MikeMontana1968/tide-machine/pcb/render_bottom.png

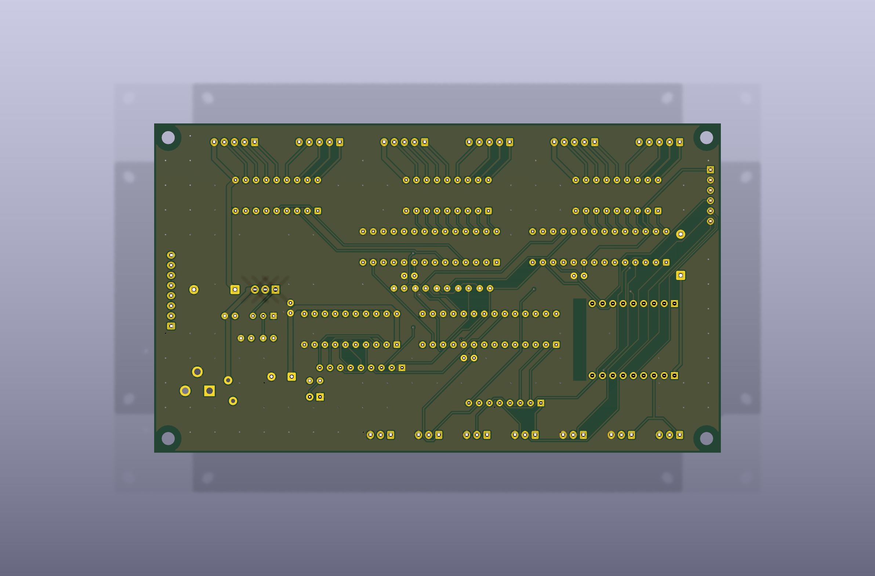
pcb/render_bottom.png
