MikeMontana1968/tide-machine/pcb/render_top.png

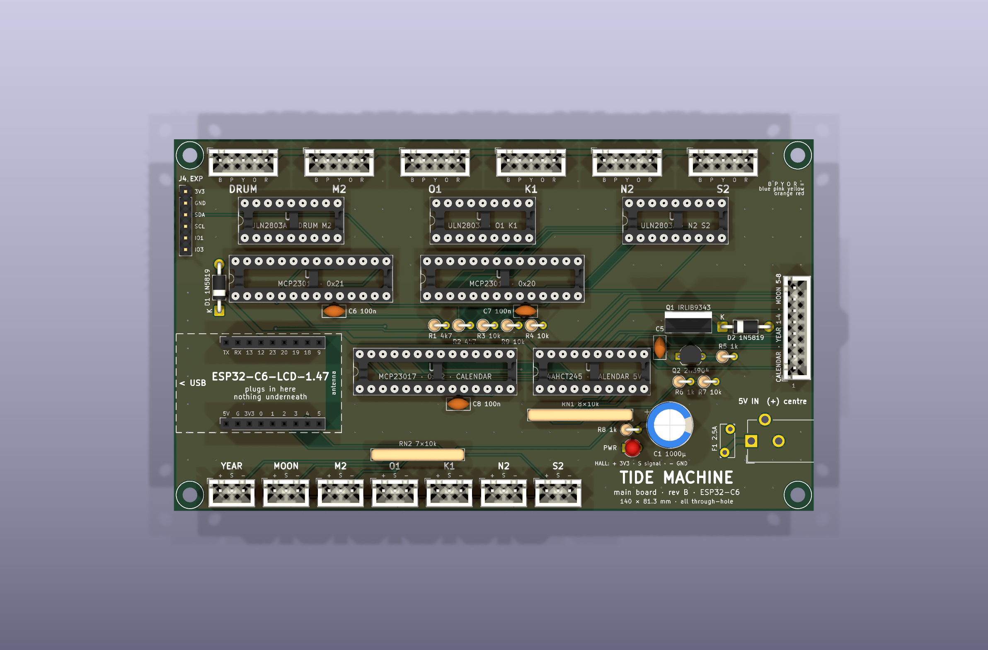
pcb/render_top.png
