MikeMontana1968/tide-machine/stl/README.txt

Tide Machine rev M: printed parts (from station_study.py --full; regenerate with export_stl.py)

PLA, 3 perimeters, no supports. Print the coupons first (RESUME.md, Printing).

hub_dial.stl               x5     52.0 x   52.0 x   5.0 mm   dial back down, boss up
arm_S2.stl                 x1     26.2 x   24.0 x   4.5 mm   back down, bearing boss up (pin radius 8.75 mm)
arm_N2.stl                 x1     24.9 x   24.0 x   4.5 mm   back down, bearing boss up (pin radius 7.35 mm)
arm_K1.stl                 x1     24.0 x   24.0 x   4.5 mm   back down, bearing boss up (pin radius 3.5 mm)
arm_O1.stl                 x1     24.0 x   24.0 x   4.5 mm   back down, bearing boss up (pin radius 2.45 mm)
arm_M2.stl                 x1     52.5 x   24.0 x   4.5 mm   back down, bearing boss up (pin radius 35 mm)
index_tab.stl              x5      6.0 x    6.0 x   4.5 mm   flat
pulley_bracket.stl         x6     30.0 x   15.7 x  15.8 mm   rail face down, as modelled
pen_carriage_rear.stl      x1     32.0 x   24.0 x   4.2 mm   front face down, pulley stub up
pen_carriage_front.stl     x1     32.0 x   24.0 x   9.0 mm   front face down, pockets open upward
year_dial.stl              x1     52.0 x   52.0 x   6.5 mm   decal face down. Hub bore is a PLACEHOLDER until the BKA30D-R5's shafts are measured
moon_disc.stl              x1     32.0 x   32.0 x   6.0 mm   decal face down. Hub bore is a PLACEHOLDER until the BKA30D-R5's shafts are measured
calendar_hand.stl          x1      6.2 x   17.0 x  12.0 mm   front face down
drum_end_cap.stl           x2     77.9 x   77.9 x   6.0 mm   flat. 7.1 mm bore added for the 7 mm shaft; how it grips the shaft is not designed yet
