MikeMontana1968/tide-machine/rails_1to1_A2.pdf

# TIDE MACHINE — RAILS AND FRAME drilling templates, 1:1

1×2 pine. Templates, not a cut file — tape a sheet to the wood, centre-punch every cross, then drill. PRINT AT 100% / ACTUAL SIZE.

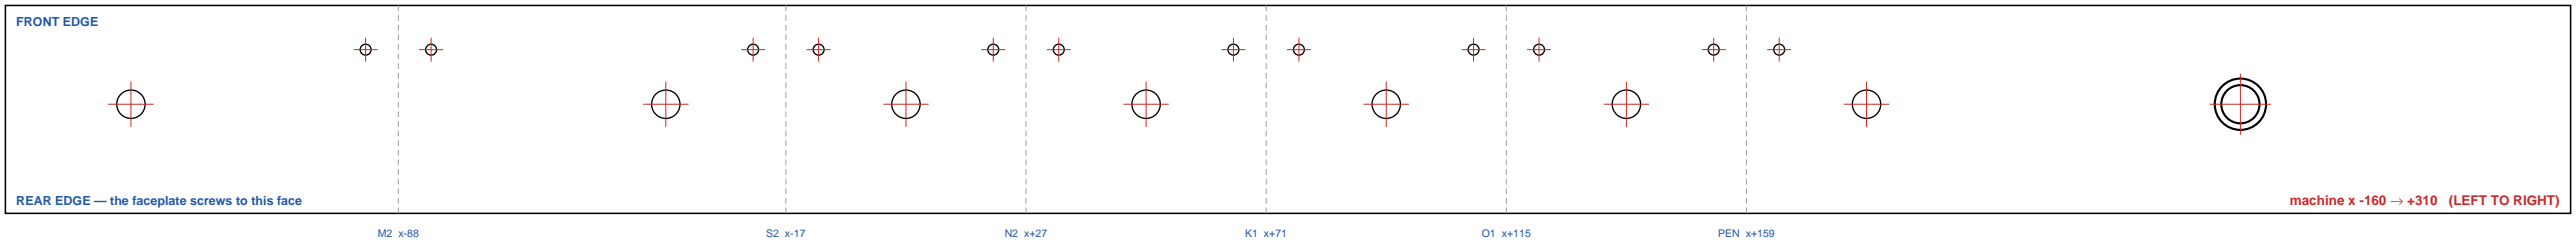
[picture p3: figure]
FRONT EDGE; machine x -160 → +310 (LEFT TO RIGHT); PEN x+159

REAR EDGE — the faceplate screws to this face

TOP RAIL — inner face (drill this face)

inner face, 470 × 38.10. 7 blind rod sockets, 12 screw-eye pilots, 1 through hole for the drum shaft.

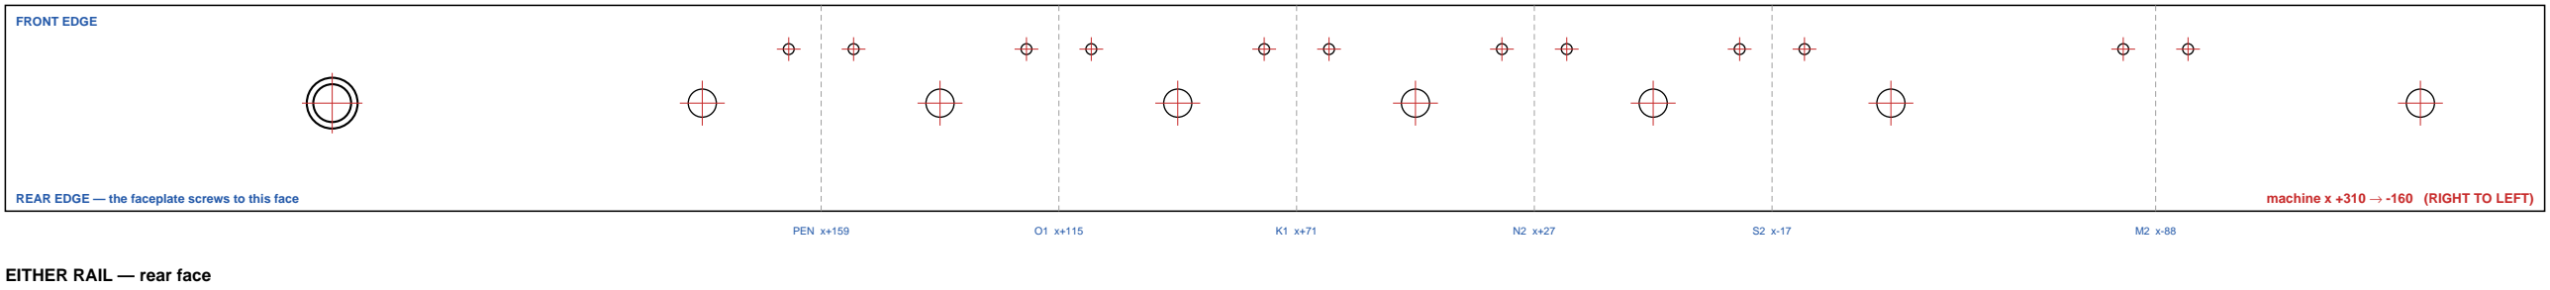
[picture p4: figure]
FRONT EDGE; machine x +310 → -160 (RIGHT TO LEFT); PEN x+159; EITHER RAIL — rear face

REAR EDGE — the faceplate screws to this face

BOTTOM RAIL — inner face (drill this face)

inner face, 470 × 38.10. 7 blind rod sockets, 12 screw-eye pilots, 1 through hole for the drum shaft.

REAR EDGE — the faceplate screws to this face

FRONT EDGE

machine x -160 → +310 (LEFT TO RIGHT) rear face, 470 × 19.05. The SAME for both rails — the pilots sit 6 mm in from the inner edge either way.

M2 x-88 | S2 x-17 | N2 x+27 | K1 x+71 | O1 x+115 | PEN x+159

END POST — 2 off, blank

140 × 38.1 from the same 1×2. Stands on end between the rails and closes the box.

No joinery drawn — that is still an open item. Fit the rails and rods dry, get it square,

then fasten the posts to whatever you have.

THE TWO RAILS ARE MIRROR IMAGES. Use the template with the matching name.
Both rails carry the same features at the same machine (x, z) — but each is drilled on its INNER face, the one that looks at the other rail. Laying the top rail inner-face-up turns it over, so with the rear edge toward you on both, machine x runs left-to-right on one rail and right-to-left on the other. Drill both from one template and the second rail is scrap.
Each template names its rail and states which way x runs. Register the REAR EDGE first, then the end.

Drill schedule
7 × Ø5.2 × 9 deep, BLIND | guide-rod sockets, 20 mm from the rear edge
12 × Ø2.0 × 9 deep | screw-eye pilots, 30 mm from the rear edge
1 × Ø7.0 THROUGH (19.05) | drum shaft at x +249.5, both rails
5 × Ø2.0 × ~10 deep | faceplate pilots — REAR face, 6 mm in from the inner edge

The screw-eye pilots leave only 8.1 mm of wood to the front edge — drill them square or pine will blow out.

Cut list
2 × rail 1×2 pine, 470 mm (19.05 × 38.1 actual)
2 × post 1×2 pine, 140 mm — stands between the rails
7 × rod Ø5 mm, 158 mm — socket bottom to socket bottom One 8 ft 1×2 covers all four wood parts (1220 mm needed).

Ordinates (machine x, mm; measure rather than trust the print)

Rod sockets Ø5.2, v 20

-137
-39
+5
+49
+93
+137
+181
—
—
—
—
—

Screw eyes Ø2.0, v 30

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
+109
+121
+153
+165

Faceplate pilots Ø2.0, v 6

-144.00
-69.75
+4.50
+78.75
+153.00

Drum shaft Ø7.0, v 20

+249.5 THROUGH

THIS BAR IS 100 mm — measure it before trusting this sheet
