MikeMontana1968/tide-machine/pcb/placement.png

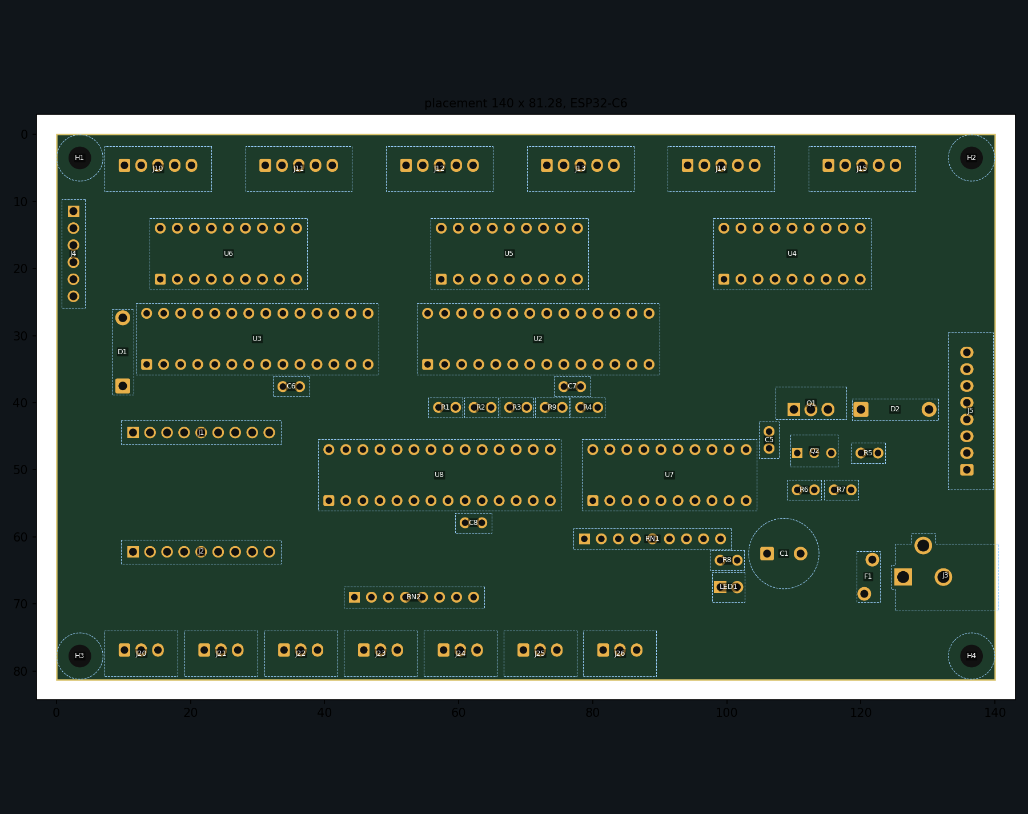
pcb/placement.png
