MikeMontana1968/tide-machine/pcb/routed_both.png

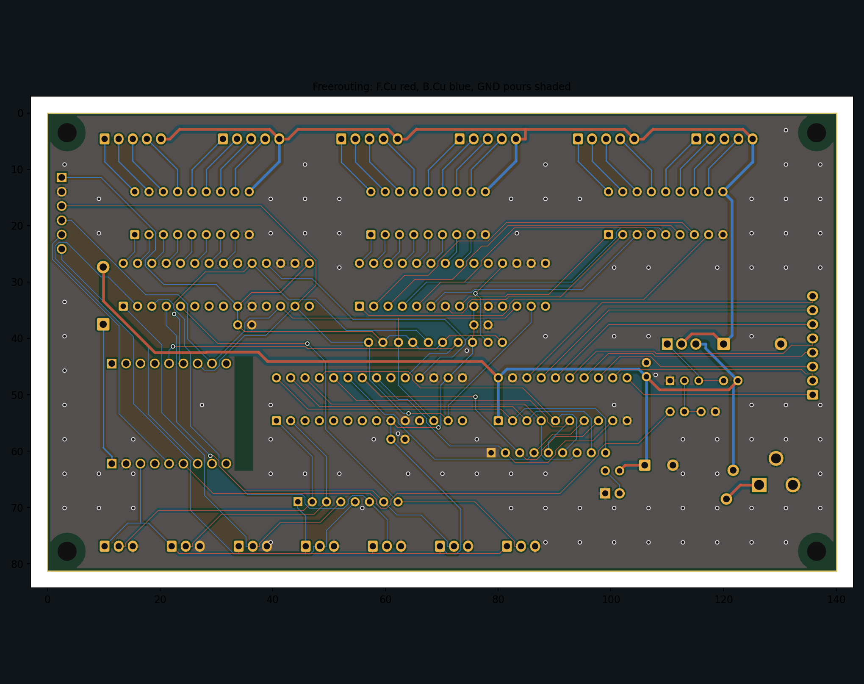
pcb/routed_both.png
