MikeMontana1968/tide-machine/pcb/routed_top.png

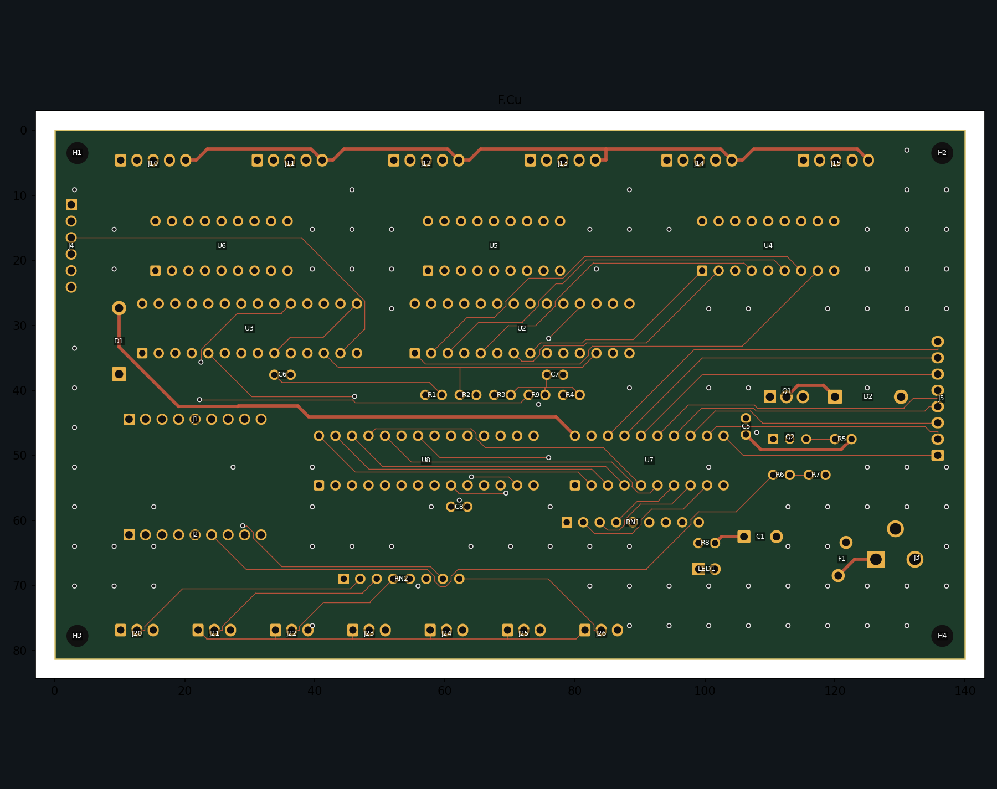
pcb/routed_top.png
