MikeMontana1968/tide-machine/pcb/silk_layout.png

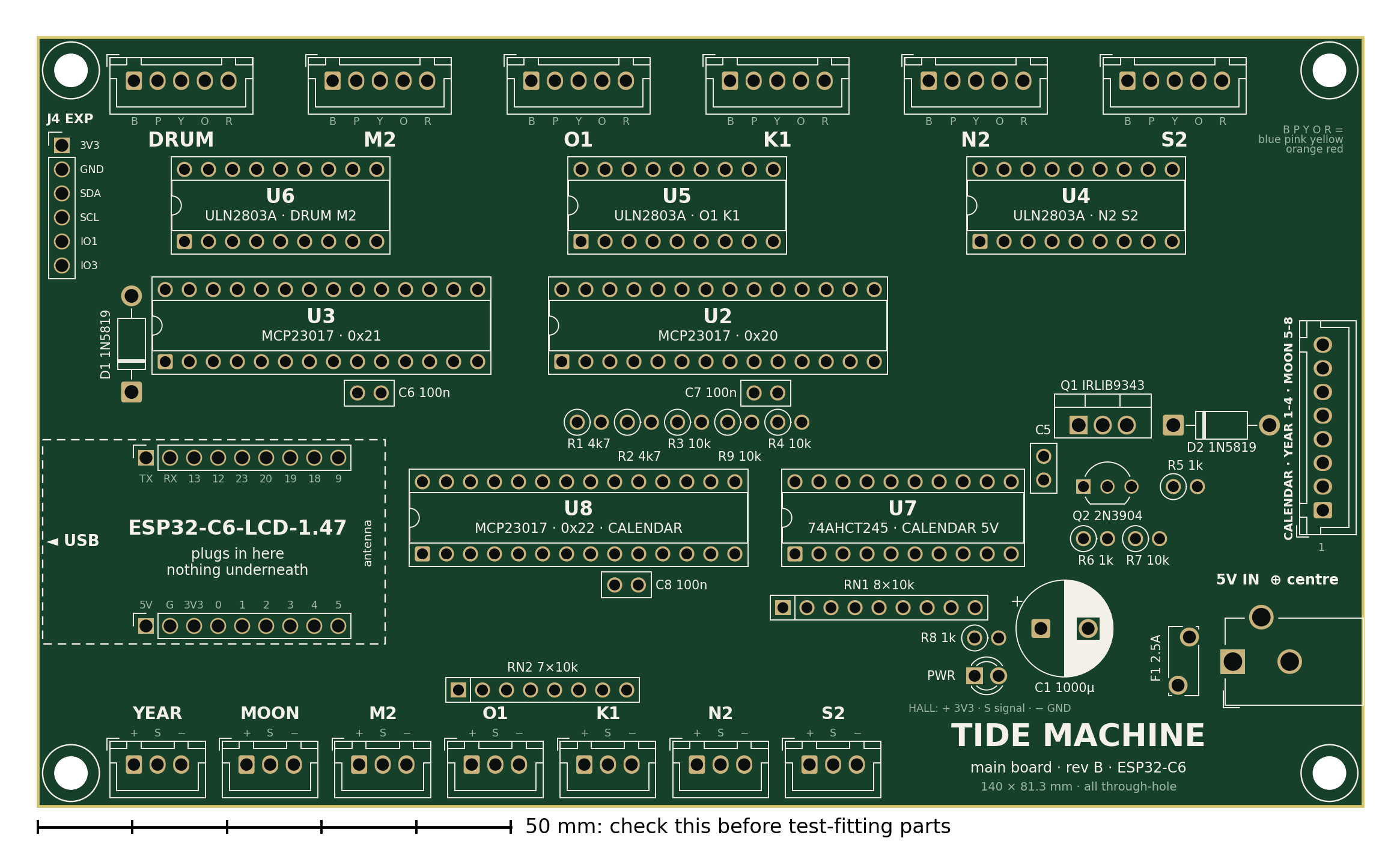
pcb/silk_layout.png
