MikeMontana1968/tide-machine/bom.csv

Section | Item | Spec / part number | Need | Order | Notes | Flag
Motion | Stepper motor | 28BYJ-48 5 V (64:1), usually sold as a kit with a ULN2003 board | 6 | 7 | Five stations + the drum. The motors plug straight into the main board; the kit's driver boards aren't needed. A 10-pack is usually cheaper per unit.
Motion | Dual-shaft gauge stepper | BKA30D-R5 (continuous 360° version) | 1 | 2 | Calendar: outer shaft = year dial, inner shaft = moon disc. Confirm both shafts spin all the way round, and measure shaft diameters and lengths, before building around it. | VERIFY BEFORE BUILDING AROUND IT
Motion | V-groove bearing | V623ZZ, 3 × 12 × 4 mm | 22 | 25 | 12 rail pulleys, 5 arms, 1 pen pulley, 4 pen carriage. Measure the groove root radius (4.8 assumed) and V angle (90° assumed) on arrival. | VERIFY BEFORE BUILDING AROUND IT
Motion | Steel rod | 3 mm ground stainless (h6), or 1/8″ (3.175 mm) O-1 drill rod | 2 × 170 mm | 2 × 300 mm | Pen guide rods, cut to 170 socket bottom to socket bottom. 4 mm and up won't seat in the V623's groove.
Motion | Shim washer | 3 × 5 × 0.5 mm (OD must be 5 mm or less) | 16 | 25 | Between the two bearings in each pulley bracket (6), behind each pen-carriage bearing (4), under each arm-bearing axle head (5) and the pen-pulley axle head (1). A standard M3 washer presses on the bearing shields.
Motion | Monofilament line | 0.30 mm fluorocarbon (about 12 lb) | about 2 m | 1 spool | Not nylon: nylon absorbs moisture and wanders with humidity.
Motion | Crimp sleeves | Aluminium or copper, 0.6–0.8 mm ID, for 0.3 mm line | 4 | 20 | Crimp, don't knot.
Sensing | Hall-effect latch | TI DRV5013AGQLPG (±6 mT, through-hole TO-92); a few DRV5013BCQLPG (±12 mT) to compare | 7 | 10 | Five stations + year + moon. Choose a variant that switches at a few mT, so a nearby motor's stray field can't trip it; bench-test one beside a running 28BYJ-48. The TO-92 needs a slightly larger plate window than the old SOT-23 plan. | VERIFY BEFORE BUILDING AROUND IT
Sensing | Magnets | N52 neodymium disc, 5 × 2 mm, axially magnetised | 14 (7 pairs) | 20 | Glued into the pockets in the back of each dial, opposite poles facing the sensor.
Sensing | Sensor carriers | Cut from the perfboard below, about 10 × 16 mm each | 7 |  | Each holds a latch flat in its plate window, with a 100 nF capacitor across its supply and a 3-core lead to the main board.
Main board | Printed circuit board | 2-layer, 1.6 mm, 140 × 81.3 mm (5.5 × 3.2 in), from the Gerbers in pcb/ | 1 | 5 (the usual minimum) | Routed and DRC-clean: upload pcb/tide_main_gerbers.zip to JLCPCB (2 layers, 1.6 mm, HASL). Mounts behind the faceplate on four standoffs.
Main board | Microcontroller | Waveshare ESP32-C6-LCD-1.47 (ESP32-C6, 1.47-inch 172 × 320 LCD) | 1 | a 2-pack | Bought separately. Plugs into the socket below, USB-C out of the board's left edge. Uses GPIO 18/19 (I²C), 20 and 23 (interrupts), 2 (hold PWM); 1 and 3 go to the expansion header.
Main board | ESP32 socket | 1 × 9 female header, 2.54 mm pitch, about 8.5 mm tall (Samtec SSW-109-01-T-S) | 2 | 3 | The C6 board plugs in, so it can be swapped or flashed off the board. Rows are 17.78 mm apart.
Main board | I/O expander | MCP23017-E/SP, DIP-28 | 3 | 4 | 0x20 drives O1, K1, N2, S2; 0x21 drives M2 and the drum and reads the five station latches; 0x22 drives the calendar coils and reads the year and moon latches.
Main board | Motor driver | ULN2803A, DIP-18 (8 Darlingtons with clamp diodes) | 3 | 4 | Two motors each. The clamp common goes to the switched HOLD rail.
Main board | Calendar driver | SN74AHCT245N, DIP-20 | 1 | 2 | Takes the 0x22 expander's eight 3.3 V outputs and drives the BKA30D-R5's coils at 5 V, one motor at a time. The calendar creeps about 1°/day, so microstepping buys nothing.
Main board | IC sockets | DIP-28 (×3), DIP-18 (×3), DIP-20 (×1) | 7 | 7
Main board | P-channel MOSFET | IRLIB9343PBF, TO-220 (logic level: rated at −4.5 V gate) | 1 | 2 | PWM hold: switches the motors' 5 V. Stands upright; no heatsink at 1.2 A.
Main board | NPN transistor | 2N3904, TO-92 | 1 | 5 | Drives the P-FET's gate from the ESP32's 3.3 V.
Main board | Schottky diode | 1N5819, DO-41 | 2 | 5 | One feeds the ESP32's 5 V pin (so USB and the supply never fight); one gives the motor current a path when the PWM switch opens.
Main board | Resettable fuse | Bourns MF-R250 (2.5 A hold), radial | 1 | 2 | Between the jack and the 5 V bus.
Main board | Electrolytic capacitor | 1000 µF 10 V radial, 10 mm dia, 5 mm lead pitch | 1 | 2
Main board | Ceramic capacitors | 100 nF, 2.5 mm lead pitch | 11 | 25 | Four on the main board, one on each Hall carrier.
Main board | Resistors | 1/4 W, mounted upright: 1 kΩ (×3), 10 kΩ (×4), 4.7 kΩ (×2) | 9 | an assortment | P-FET gate pull-up, transistor base, LED; base pull-down, two interrupt pull-ups and the reset pull-up; I²C pull-ups.
Main board | Resistor networks | Bussed 10 kΩ SIP: Bourns 4608X-101-103LF (8-pin) and 4609X-101-103LF (9-pin) | 1 each | 2 each | Hall pull-ups; pull-downs that hold the calendar coils off until the 0x22 expander is set up.
Main board | LED | 3 mm, green | 1 | 5 | Power indicator.
Main board | Barrel jack | Same Sky PJ-102AH, 5.5 mm, 2.0 mm pin, PCB mount | 1 | 2 | The 2.0 mm pin is the standard mate for a 5.5 × 2.1 plug.
Main board | Board connectors | JST-XH headers: B5B-XH-A (×6, motors), B3B-XH-A (×7, Halls), B8B-XH-A (×1, calendar) | 14 | 16 | The 28BYJ-48's own plug fits B5B-XH-A.
Main board | Cable connectors | JST XHP-3 (×7) and XHP-8 (×1) housings, SXH-001T-P0.6 crimps | 8 housings | a JST-XH kit | For the Hall and calendar leads. A kit with a crimp tool is easiest.
Main board | Expansion header | 1 × 6 male, 2.54 mm | 1 | 1 | 3V3, GND, SDA, SCL, GPIO1, GPIO3: room for an RTC later.
Main board | Power supply | 5 V 3 A regulated, 5.5 × 2.1 mm plug, centre positive (MEAN WELL GST18U05-P1J) | 1 | 1 | Peak draw about 1.5 A with every motor energised.
Off-board wiring | Prototype board | Double-sided perfboard, about 70 × 90 mm | 1 | 2 | Calendar carrier (holds the BKA30D-R5 behind the plate) and the seven Hall carriers.
Off-board wiring | Wire | 3-core 26 AWG for the Hall runs; 8-core (or ribbon) for the calendar | 7 Hall runs + 1 | 5 m of each
Fasteners | M3 × 20 + nyloc | Button or socket head | 6 | 10 | Pulley-bracket axles.
Fasteners | M3 × 8 button head |  | 5 | 10 | Arm bearing axles.
Fasteners | M3 × 16 button head |  | 5 | 10 | Pen-pulley axle (into the carriage insert), and the 4 carriage bearing axles, which clamp the carriage's two halves.
Fasteners | M3 hex nuts |  | 4 | 10 | Carriage bearing axles, on the rear plate.
Fasteners | M3 × 8 pan head + nut | Head 2.4 mm tall or less | 12 | 20 | Motor ears. The dials clear the heads by 1.1 mm.
Fasteners | M3 washers |  | 12 | 25 | Under the motor-ear nuts only; never against a bearing (use the shims).
Fasteners | M3 × 4 heat-set inserts | OD about 4.6 mm | 6 | 20 | Five arms + the pen carriage.
Fasteners | M2 × 6 + nut |  | 30 | 50 | Arm to hub, Hall boards, calendar board, index tabs, index hand.
Fasteners | #4 × 3/4″ flat-head wood screws |  | 12 | 20 | Pulley brackets.
Fasteners | #6 × 3/4″ wood screws |  | 10 | 20 | Faceplate to the rails' rear faces.
Fasteners | #6 × 1-1/2″ wood screws |  | 4 | 10 | End posts, through the rail into the post's end grain, with glue (a 3/4″ screw can't reach through the 19 mm rail).
Fasteners | M3 × 30 standoffs + M3 × 6 screws | Female-female hex, brass or nylon | 4 + 8 | 4 + 10 | Main board to the back of the faceplate, clear of the motors (20.5 deep).
Frame and materials | Pine 1 × 2 | 19 × 38 mm actual, 8 ft length | 1302 mm | 1 (+1 for mistakes) | Two rails 499 mm, two posts 152 mm.
Frame and materials | Faceplate | 1.5 mm (0.063″) 5052 aluminium, laser cut, about 283 × 176 mm | 1 | not yet | The DXF comes from the Ruby port. Never steel: the Hall sensors look through it. | NOT YET
Frame and materials | PVC pipe | 3″ Schedule 40 | 130 mm | a short length | The drum.
Frame and materials | Drum shaft and bearing | 7 mm steel or brass rod about 200 mm; PTFE tube or bushing; M8 washer | 1 set | 1 set
Frame and materials | Pen | Fine fibre-tip, 0.3–0.5 mm | 1 | 2
Frame and materials | Leaf spring | 0.1–0.2 mm spring-steel shim strip | 1 | a small piece | Pen contact force, about 0.05 N.
Frame and materials | Pen ballast | Steel or lead shot (or tungsten putty) | about 20 g | 1 pack | Brings the carriage to 41 g all-up.
Frame and materials | PLA filament |  | about 300 g | 1 spool if not on hand
Frame and materials | Clear silicone adhesive | Any small tube (RTV type) | a dab | 1 tube if not on hand | Fallback only, for a station hub or calendar adapter that's loose on its shaft after the D-bore test coupon. It peels off. Not threadlocker: it barely cures against plastic.
Frame and materials | Decal stock | Laser-printable white vinyl sticker paper, Letter | 1 sheet | 1 pack | For decals_1to1.pdf.
