MikeMontana1968/tide-machine/faceplate_REF.dxf

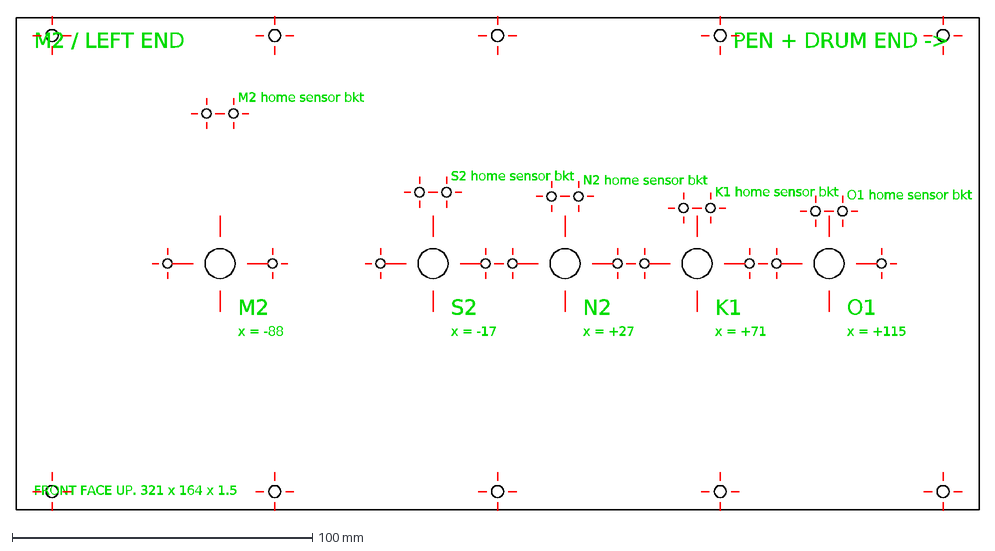
[picture p10: CAD file, 2026-09-24]
faceplate_REF.dxf
M2
x = -88
M2 home sensor bkt
S2
x = -17
S2 home sensor bkt
N2
x = +27
N2 home sensor bkt
K1
x = +71
K1 home sensor bkt
O1
x = +115
O1 home sensor bkt
M2 / LEFT END
PEN + DRUM END ->
FRONT FACE UP. 321 x 164 x 1.5
