MikeMontana1968/tide-machine/stl/arm_S2.stl

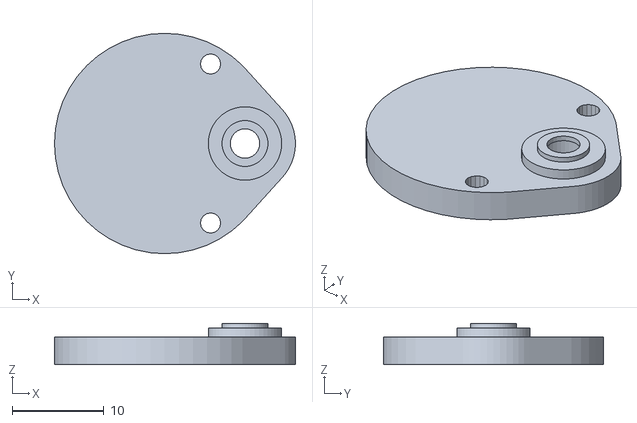
[picture p11: CAD file, 2026-09-28]
stl/arm_S2.stl
26.2 x 24.0 x 4.50
