MikeMontana1968/tide-machine/rails_REF.dxf

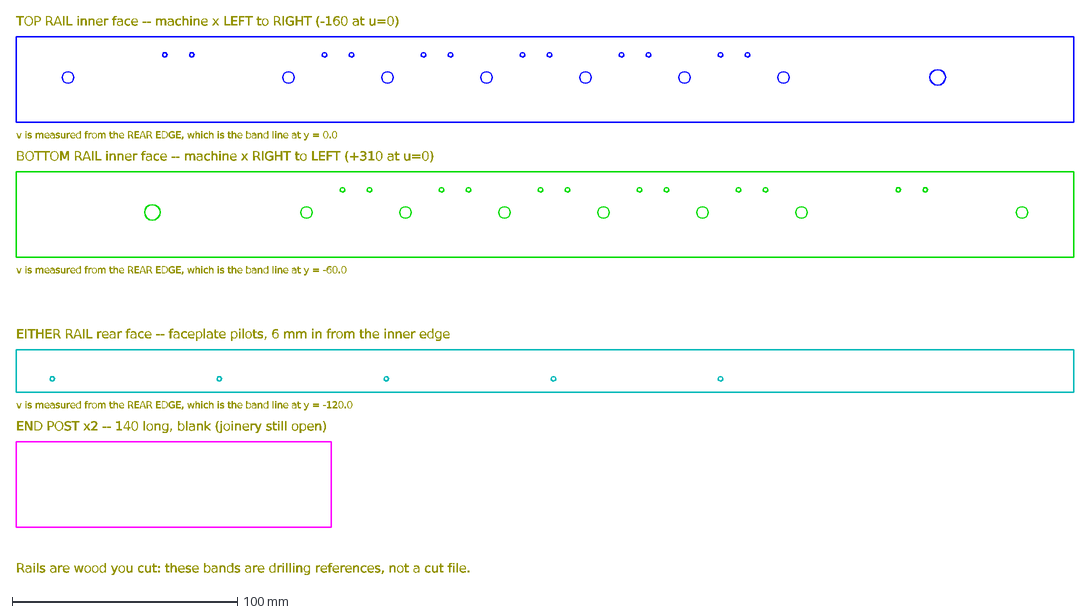
[picture p12: CAD file, 2026-09-24]
rails_REF.dxf
TOP RAIL inner face -- machine x LEFT to RIGHT (-160 at u=0)
v is measured from the REAR EDGE, which is the band line at y = 0.0
BOTTOM RAIL inner face -- machine x RIGHT to LEFT (+310 at u=0)
v is measured from the REAR EDGE, which is the band line at y = -60.0
EITHER RAIL rear face -- faceplate pilots, 6 mm in from the inner edge
v is measured from the REAR EDGE, which is the band line at y = -120.0
END POST x2 -- 140 long, blank (joinery still open)
Rails are wood you cut: these bands are drilling references, not a cut file.
