MikeMontana1968/tide-machine/stl/hub_dial.stl

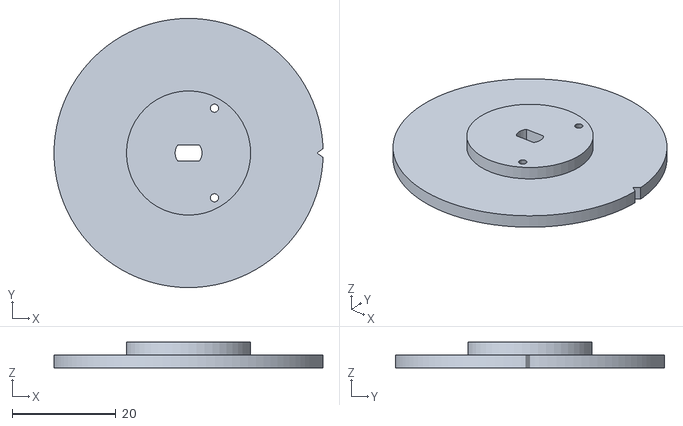
[picture p13: CAD file, 2026-09-28]
stl/hub_dial.stl
52.0 x 52.0 x 5.00
