MikeMontana1968/tide-machine/faceplate_CUT.dxf

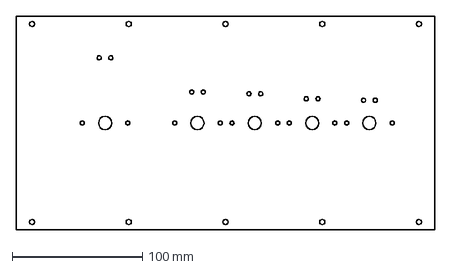
[picture p14: CAD file, 2026-09-24]
faceplate_CUT.dxf
321.0 x 164.0 mm
