MikeMontana1968/tide-machine/stl/arm_M2.stl

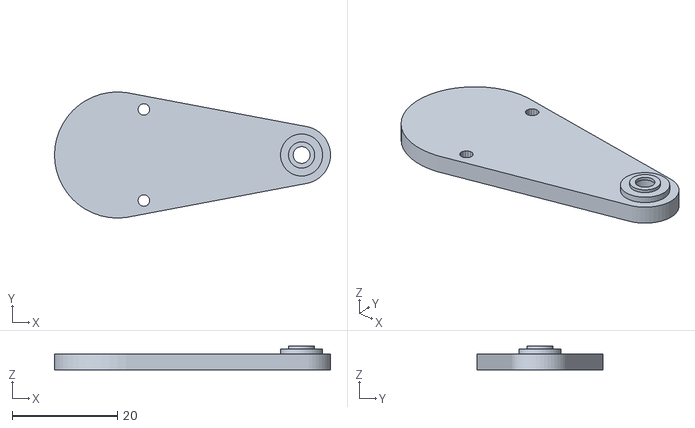
[picture p15: CAD file, 2026-09-28]
stl/arm_M2.stl
52.5 x 24.0 x 4.50
