MikeMontana1968/tide-machine/stl/arm_K1.stl

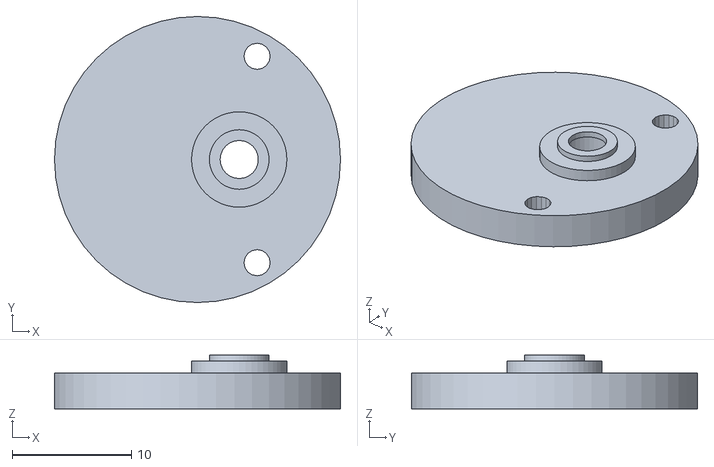
[picture p16: CAD file, 2026-09-28]
stl/arm_K1.stl
24.0 x 24.0 x 4.50
