MikeMontana1968/tide-machine/stl/arm_N2.stl

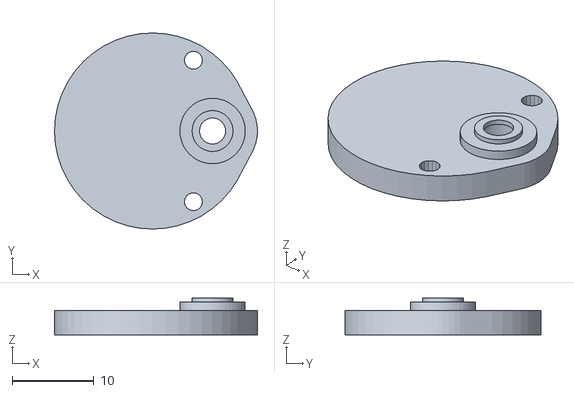
[picture p17: CAD file, 2026-09-28]
stl/arm_N2.stl
24.9 x 24.0 x 4.50
