MikeMontana1968/tide-machine/stl/year_dial.stl

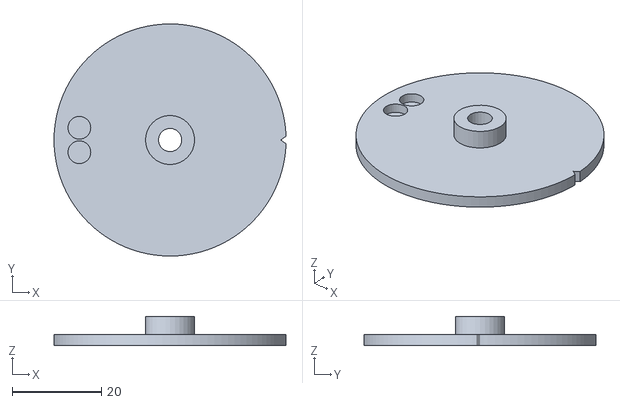
[picture p18: CAD file, 2026-09-28]
stl/year_dial.stl
52.0 x 52.0 x 6.50
