MikeMontana1968/tide-machine/stl/moon_disc.stl

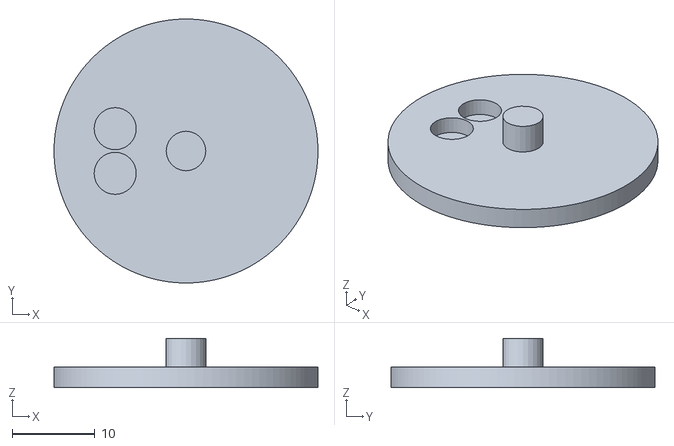
[picture p19: CAD file, 2026-09-28]
stl/moon_disc.stl
32.0 x 32.0 x 6.00
