MikeMontana1968/tide-machine/stl/pen_carriage_front.stl

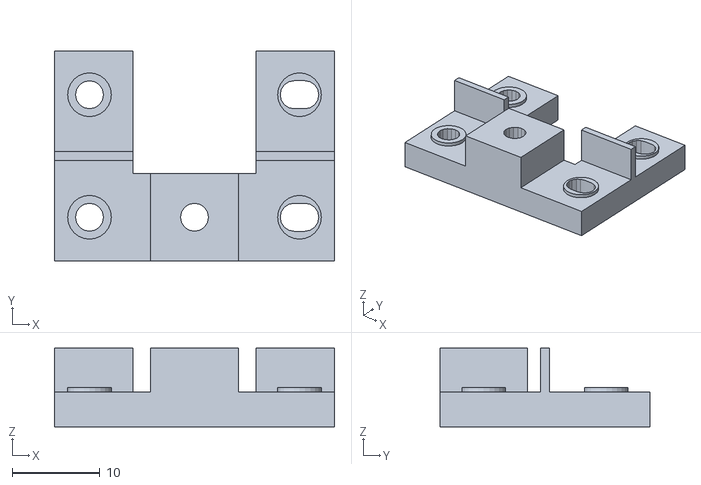
[picture p20: CAD file, 2026-09-28]
stl/pen_carriage_front.stl
32.0 x 24.0 x 9.00
