MikeMontana1968/tide-machine/stl/drum_end_cap.stl

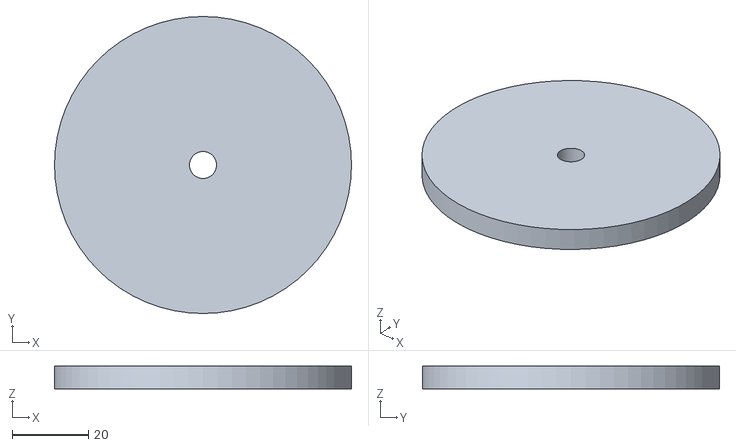
[picture p21: CAD file, 2026-09-28]
stl/drum_end_cap.stl
77.9 x 77.9 x 6.00
