MikeMontana1968/tide-machine/stl/pen_carriage_rear.stl

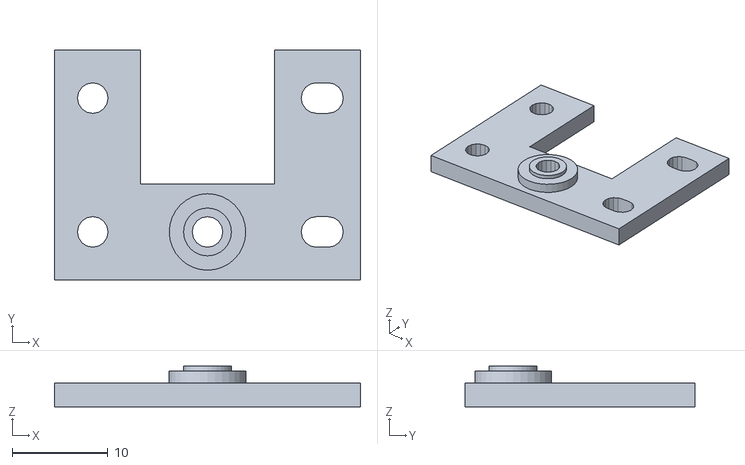
[picture p22: CAD file, 2026-09-28]
stl/pen_carriage_rear.stl
32.0 x 24.0 x 4.25
