MikeMontana1968/tide-machine/stl/index_tab.stl

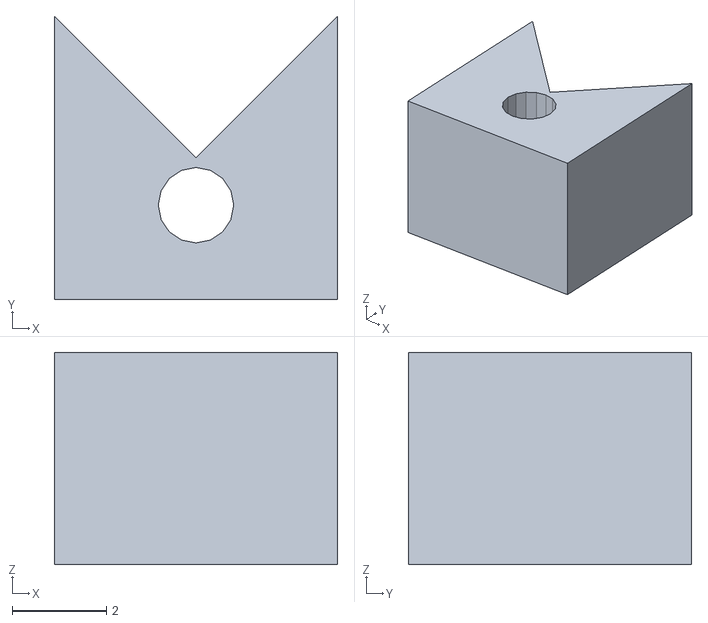
[picture p23: CAD file, 2026-09-28]
stl/index_tab.stl
6.00 x 6.00 x 4.50
