MikeMontana1968/tide-machine/stl/pulley_bracket.stl

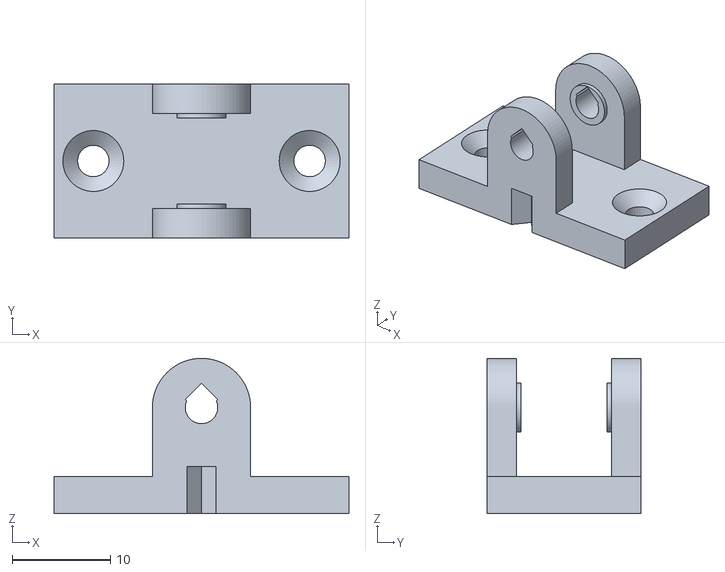
[picture p24: CAD file, 2026-09-28]
stl/pulley_bracket.stl
30.0 x 15.7 x 15.8
