MikeMontana1968/tide-machine/stl/calendar_hand.stl

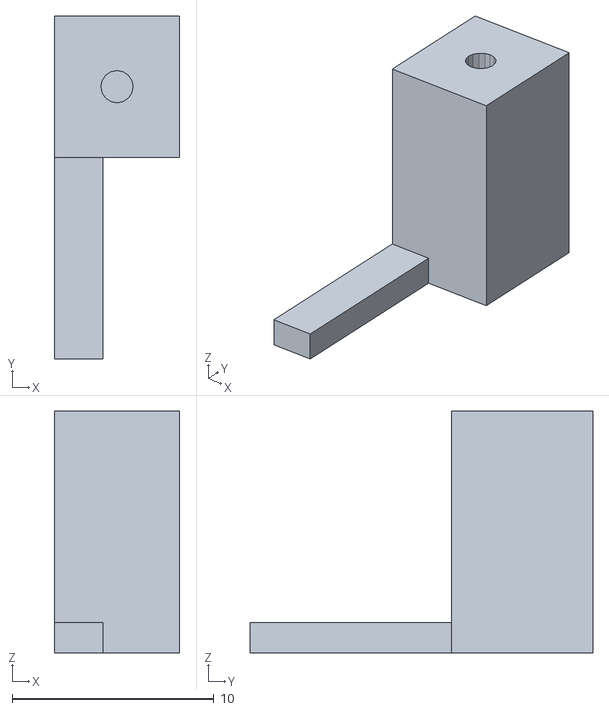
[picture p25: CAD file, 2026-09-28]
stl/calendar_hand.stl
6.20 x 17.0 x 12.0
