MikeMontana1968/tide-machine/(list of files, cad)

Other CAD files:
stl/arm_O1.stl
