MikeMontana1968/tide-machine/decals_1to1.pdf

## Tide machine Rev M · dial decals · print at 100% (no scaling)

PLACEHOLDER constituents (illustrative coast), longitude -120.76, epoch 2026-10-15 UT (u: K1 +4.3, O1 -4.8, M2 +1.2 deg). Reprint with NOAA values. Cut on the grey circles. The coral tick goes over the notch in the dial rim. Read against the index at 12 o'clock.
Calendar: the year annulus goes on the Ø52 year dial; the small moon decal goes on the Ø32 moon disc in front of it.

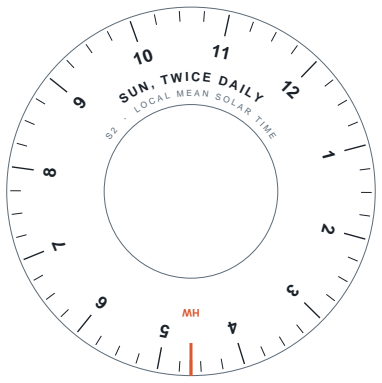
[picture p26: figure]
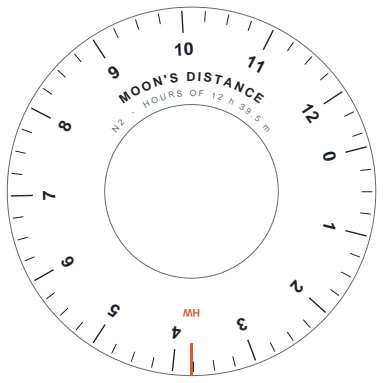
[picture p27: figure]
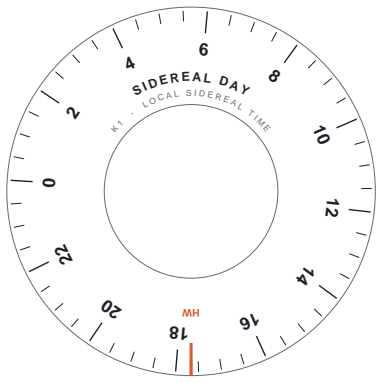
[picture p28: figure]

S 2 · L O C A L M E A N S O L A R T I M E

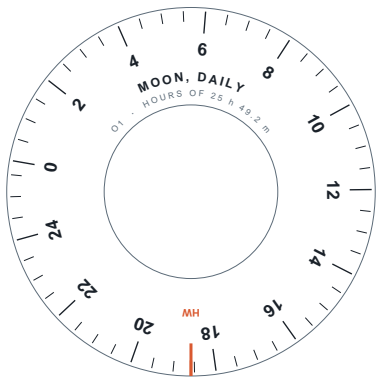
[picture p29: figure]

0

5

10

20

25

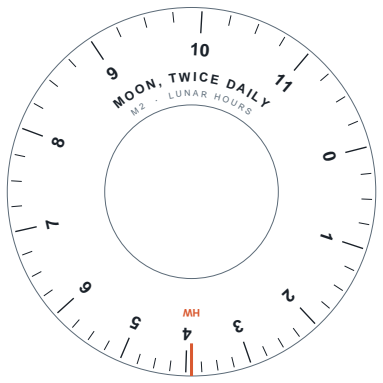
[picture p30: figure]
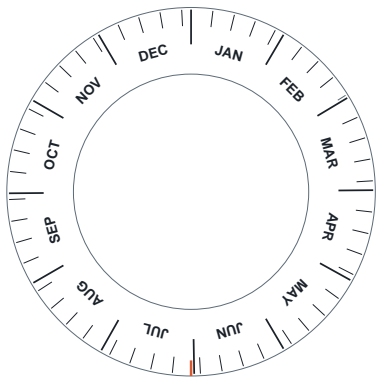
[picture p31: figure]
JAN; FEB; MAR; APR; MAY; AUG; SEP; OCT; NOV; DEC

100 mm -- measure before cutting

## Tide machine Rev M · dial decals · spare set · print at 100%

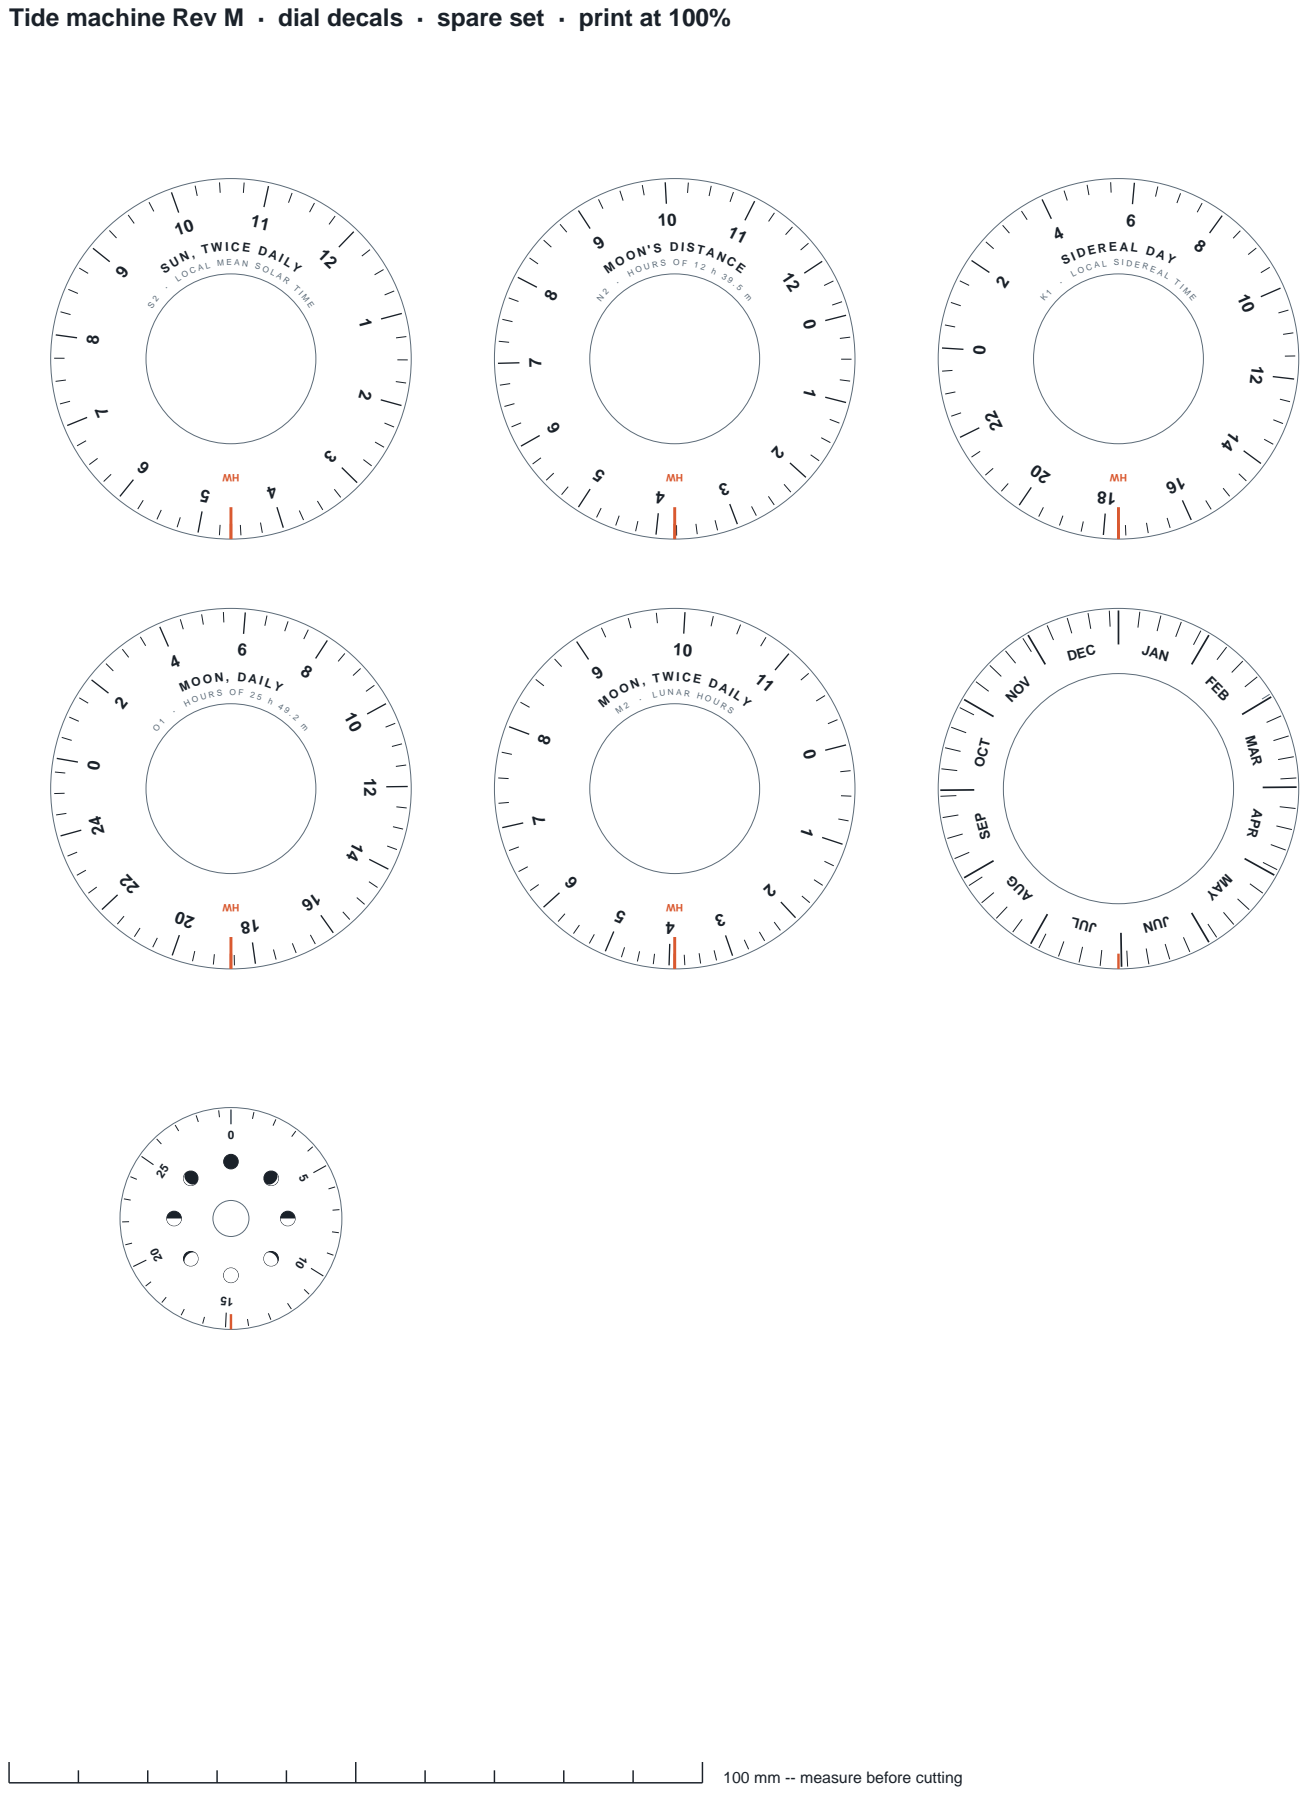
[picture p32: page 2]
JAN; FEB; MAR; APR; MAY; AUG; SEP; OCT; NOV; DEC

100 mm -- measure before cutting
