MikeMontana1968/tide-machine/faceplate_1to1_A3.pdf

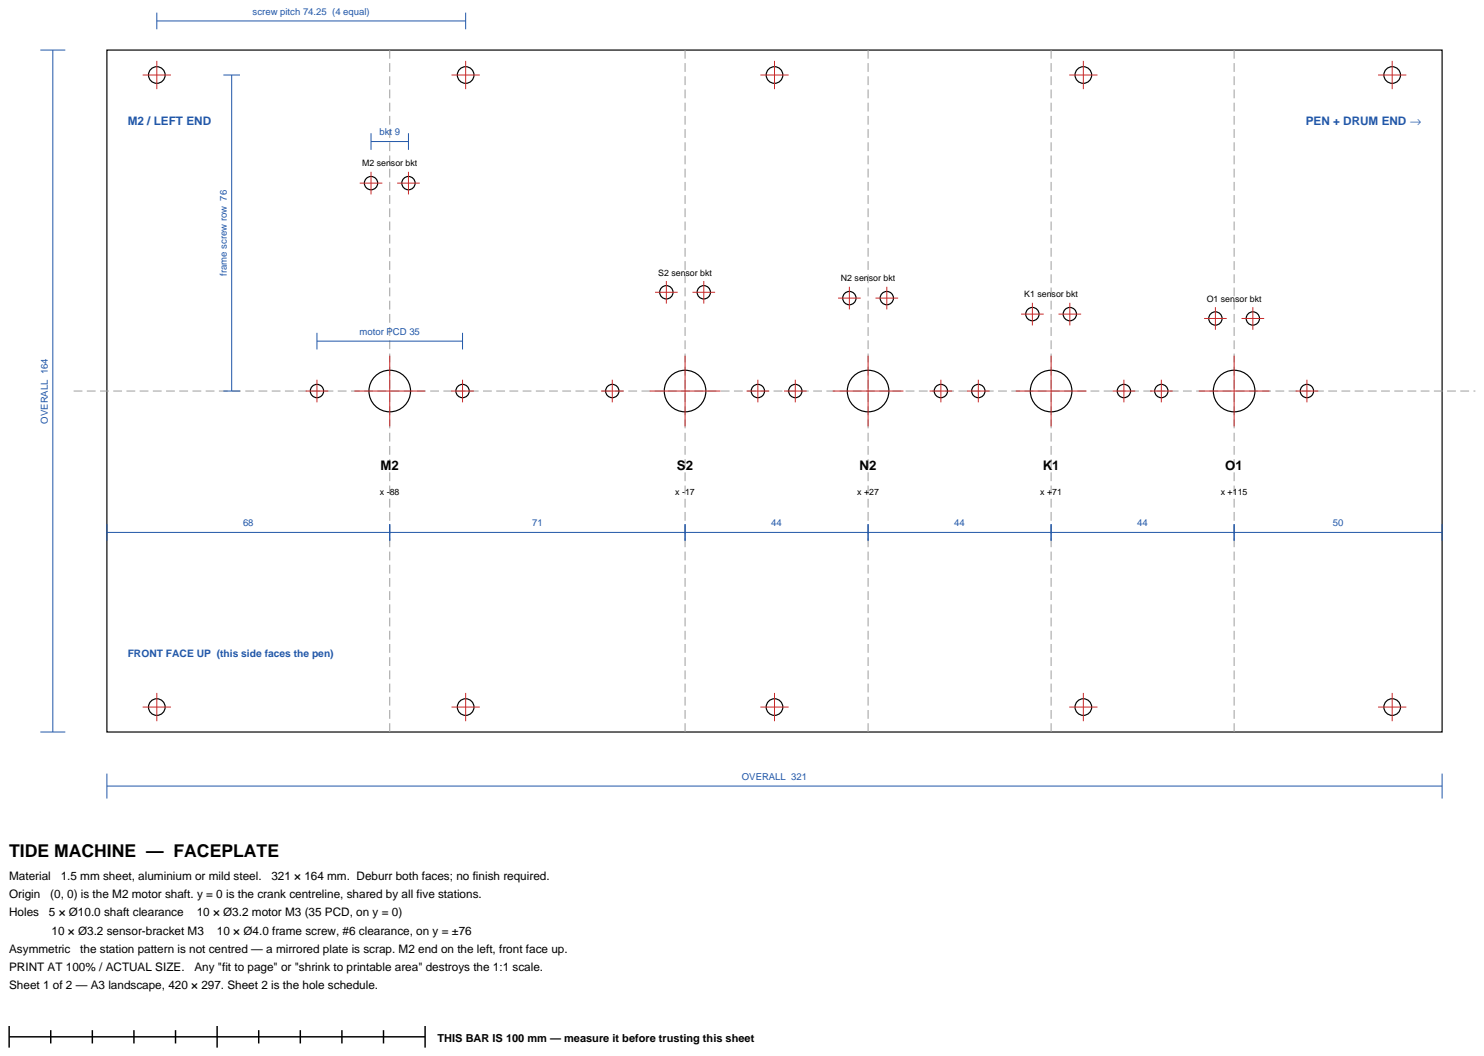
[picture p33: page 1]
M2 sensor bkt; S2 sensor bkt; N2 sensor bkt; K1 sensor bkt; O1 sensor bkt; M2 / LEFT END; PEN + DRUM END →; OVERALL 321; OVERALL 164; motor PCD 35; bkt 9

screw pitch 74.25 (4 equal)

frame screw row 76

FRONT FACE UP (this side faces the pen)

TIDE MACHINE — FACEPLATE

Material 1.5 mm sheet, aluminium or mild steel. 321 × 164 mm. Deburr both faces; no finish required.
Origin (0, 0) is the M2 motor shaft. y = 0 is the crank centreline, shared by all five stations.
Holes 5 × Ø10.0 shaft clearance 10 × Ø3.2 motor M3 (35 PCD, on y = 0)

10 × Ø3.2 sensor-bracket M3 10 × Ø4.0 frame screw, #6 clearance, on y = ±76

Asymmetric the station pattern is not centred — a mirrored plate is scrap. M2 end on the left, front face up.
PRINT AT 100% / ACTUAL SIZE. Any "fit to page" or "shrink to printable area" destroys the 1:1 scale.
Sheet 1 of 2 — A3 landscape, 420 × 297. Sheet 2 is the hole schedule.

THIS BAR IS 100 mm — measure it before trusting this sheet

# FACEPLATE — HOLE SCHEDULE

Ordinates in mm from the M2 shaft centre, 35 holes. For hand-marking, or for checking the DXF opened right.

X | Y | Ø | purpose
-88.00 | +0.00 | 10.0 M2 shaft clearance
-17.00 | +0.00 | 10.0 S2 shaft clearance
+27.00 | +0.00 | 10.0 N2 shaft clearance
+71.00 | +0.00 | 10.0 K1 shaft clearance
+115.00 | +0.00 | 10.0 O1 shaft clearance
-144.00 | -76.00 | 4.0 frame screw #6
-144.00 | +76.00 | 4.0 frame screw #6
-69.75 | -76.00 | 4.0 frame screw #6
-69.75 | +76.00 | 4.0 frame screw #6
+4.50 | -76.00 | 4.0 frame screw #6
+4.50 | +76.00 | 4.0 frame screw #6
+78.75 | -76.00 | 4.0 frame screw #6
+78.75 | +76.00 | 4.0 frame screw #6
+153.00 | -76.00 | 4.0 frame screw #6
+153.00 | +76.00 | 4.0 frame screw #6
-105.50 | +0.00 | 3.2 M2 motor M3
-92.50 | +50.00 | 3.2 M2 sensor bracket M3
-83.50 | +50.00 | 3.2 M2 sensor bracket M3
X | Y | Ø | purpose
-70.50 | +0.00 | 3.2 M2 motor M3
-34.50 | +0.00 | 3.2 S2 motor M3
-21.50 | +23.75 | 3.2 S2 sensor bracket M3
-12.50 | +23.75 | 3.2 S2 sensor bracket M3
+0.50 | +0.00 | 3.2 S2 motor M3
+9.50 | +0.00 | 3.2 N2 motor M3
+22.50 | +22.35 | 3.2 N2 sensor bracket M3
+31.50 | +22.35 | 3.2 N2 sensor bracket M3
+44.50 | +0.00 | 3.2 N2 motor M3
+53.50 | +0.00 | 3.2 K1 motor M3
+66.50 | +18.50 | 3.2 K1 sensor bracket M3
+75.50 | +18.50 | 3.2 K1 sensor bracket M3
+88.50 | +0.00 | 3.2 K1 motor M3
+97.50 | +0.00 | 3.2 O1 motor M3
+110.50 | +17.45 | 3.2 O1 sensor bracket M3
+119.50 | +17.45 | 3.2 O1 sensor bracket M3
+132.50 | +0.00 | 3.2 O1 motor M3

### Tally 20 × Ø3.2 mm 10 × Ø4.0 mm 5 × Ø10.0 mm

### Laser sanity check against 1.5 mm stock smallest hole 3.2 mm ≥ t (1.5) thinnest hole-to-edge wall 4.0 mm ≥ t geometry all closed: 1 outline + 35 circles, nothing else faceplate_CUT.dxf carries exactly this and no text
