MikeMontana1968/tide-machine/faceplate_1to1_tiled.pdf

## TIDE MACHINE — FACEPLATE

Material 1.5 mm sheet, aluminium or mild steel. 321 × 164 mm. Deburr both faces; no finish required. Origin (0, 0) is the M2 motor shaft. y = 0 is the crank centreline, shared by all five stations.
Holes 5 × Ø10.0 shaft clearance 10 × Ø3.2 motor M3 (35 PCD, on y = 0)
10 × Ø3.2 sensor-bracket M3 10 × Ø4.0 frame screw, #6 clearance, on y = ±76
Asymmetric the station pattern is not centred — a mirrored plate is scrap. M2 end on the left, front face up. PRINT AT 100% / ACTUAL SIZE. Any "fit to page" or "shrink to printable area" destroys the 1:1 scale. Sheets 2–3 are the plate at 1:1, split into two tiles with a 30 mm overlap.
Print both at 100%, trim sheet 3 on its red registration line, and tape it over the matching line on sheet 2. Then measure the 100 mm bar on BOTH sheets before marking anything.

THIS BAR IS 100 mm — measure it before trusting this sheet

Generated from tide_machine.rb — the model is the source of truth for every dimension on these sheets.

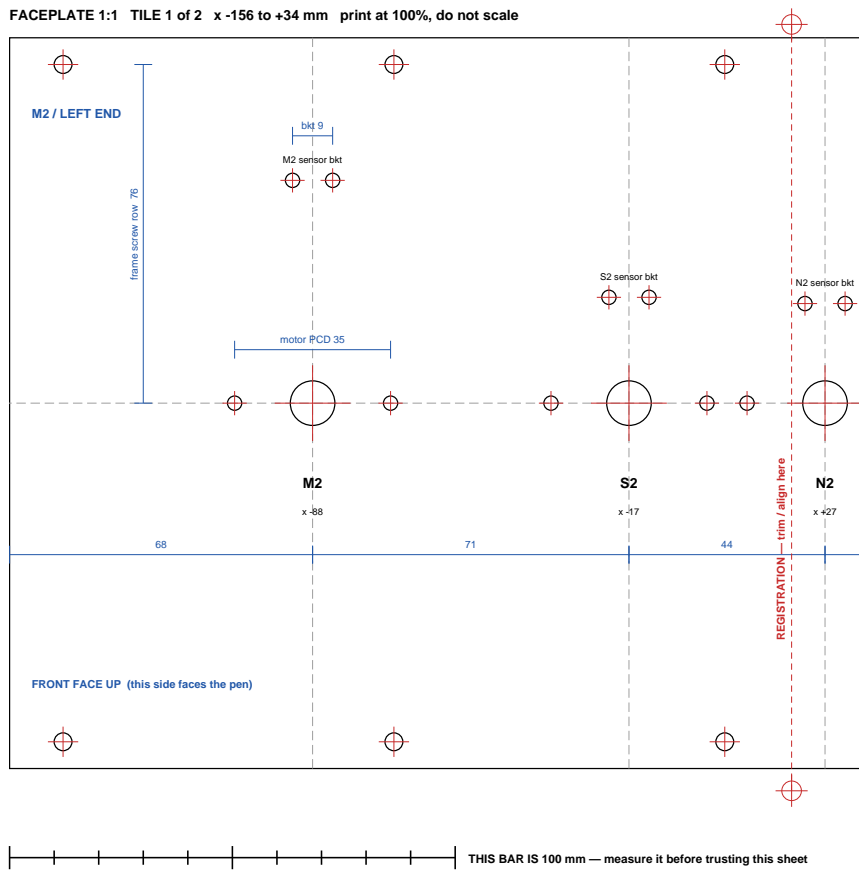
[picture p34: page 2]
M2 sensor bkt; S2 sensor bkt; N2 sensor bkt; M2 / LEFT END; motor PCD 35; bkt 9

FACEPLATE 1:1 TILE 1 of 2 x -156 to +34 mm print at 100%, do not scale

frame screw row 76

REGISTRATION — trim / align here

FRONT FACE UP (this side faces the pen)

THIS BAR IS 100 mm — measure it before trusting this sheet

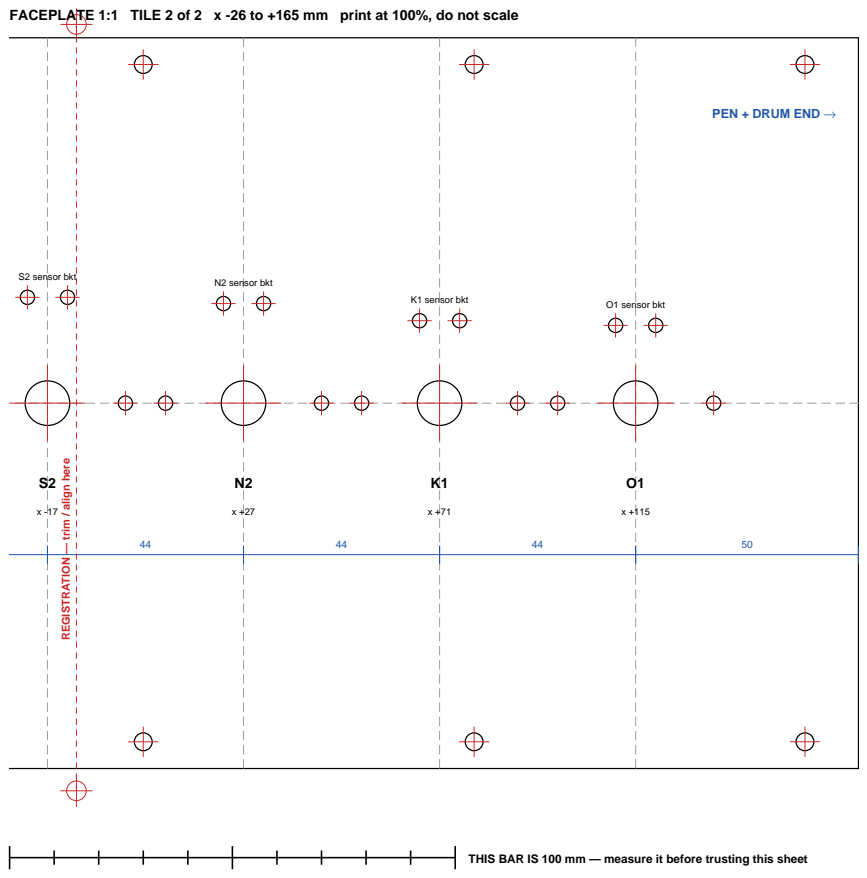
[picture p35: page 3]
S2 sensor bkt; N2 sensor bkt; K1 sensor bkt; O1 sensor bkt

FACEPLATE 1:1 TILE 2 of 2 x -26 to +165 mm print at 100%, do not scale

PEN + DRUM END →

REGISTRATION — trim / align here

THIS BAR IS 100 mm — measure it before trusting this sheet
