MikeMontana1968/tide-machine/pcb/sch.pdf

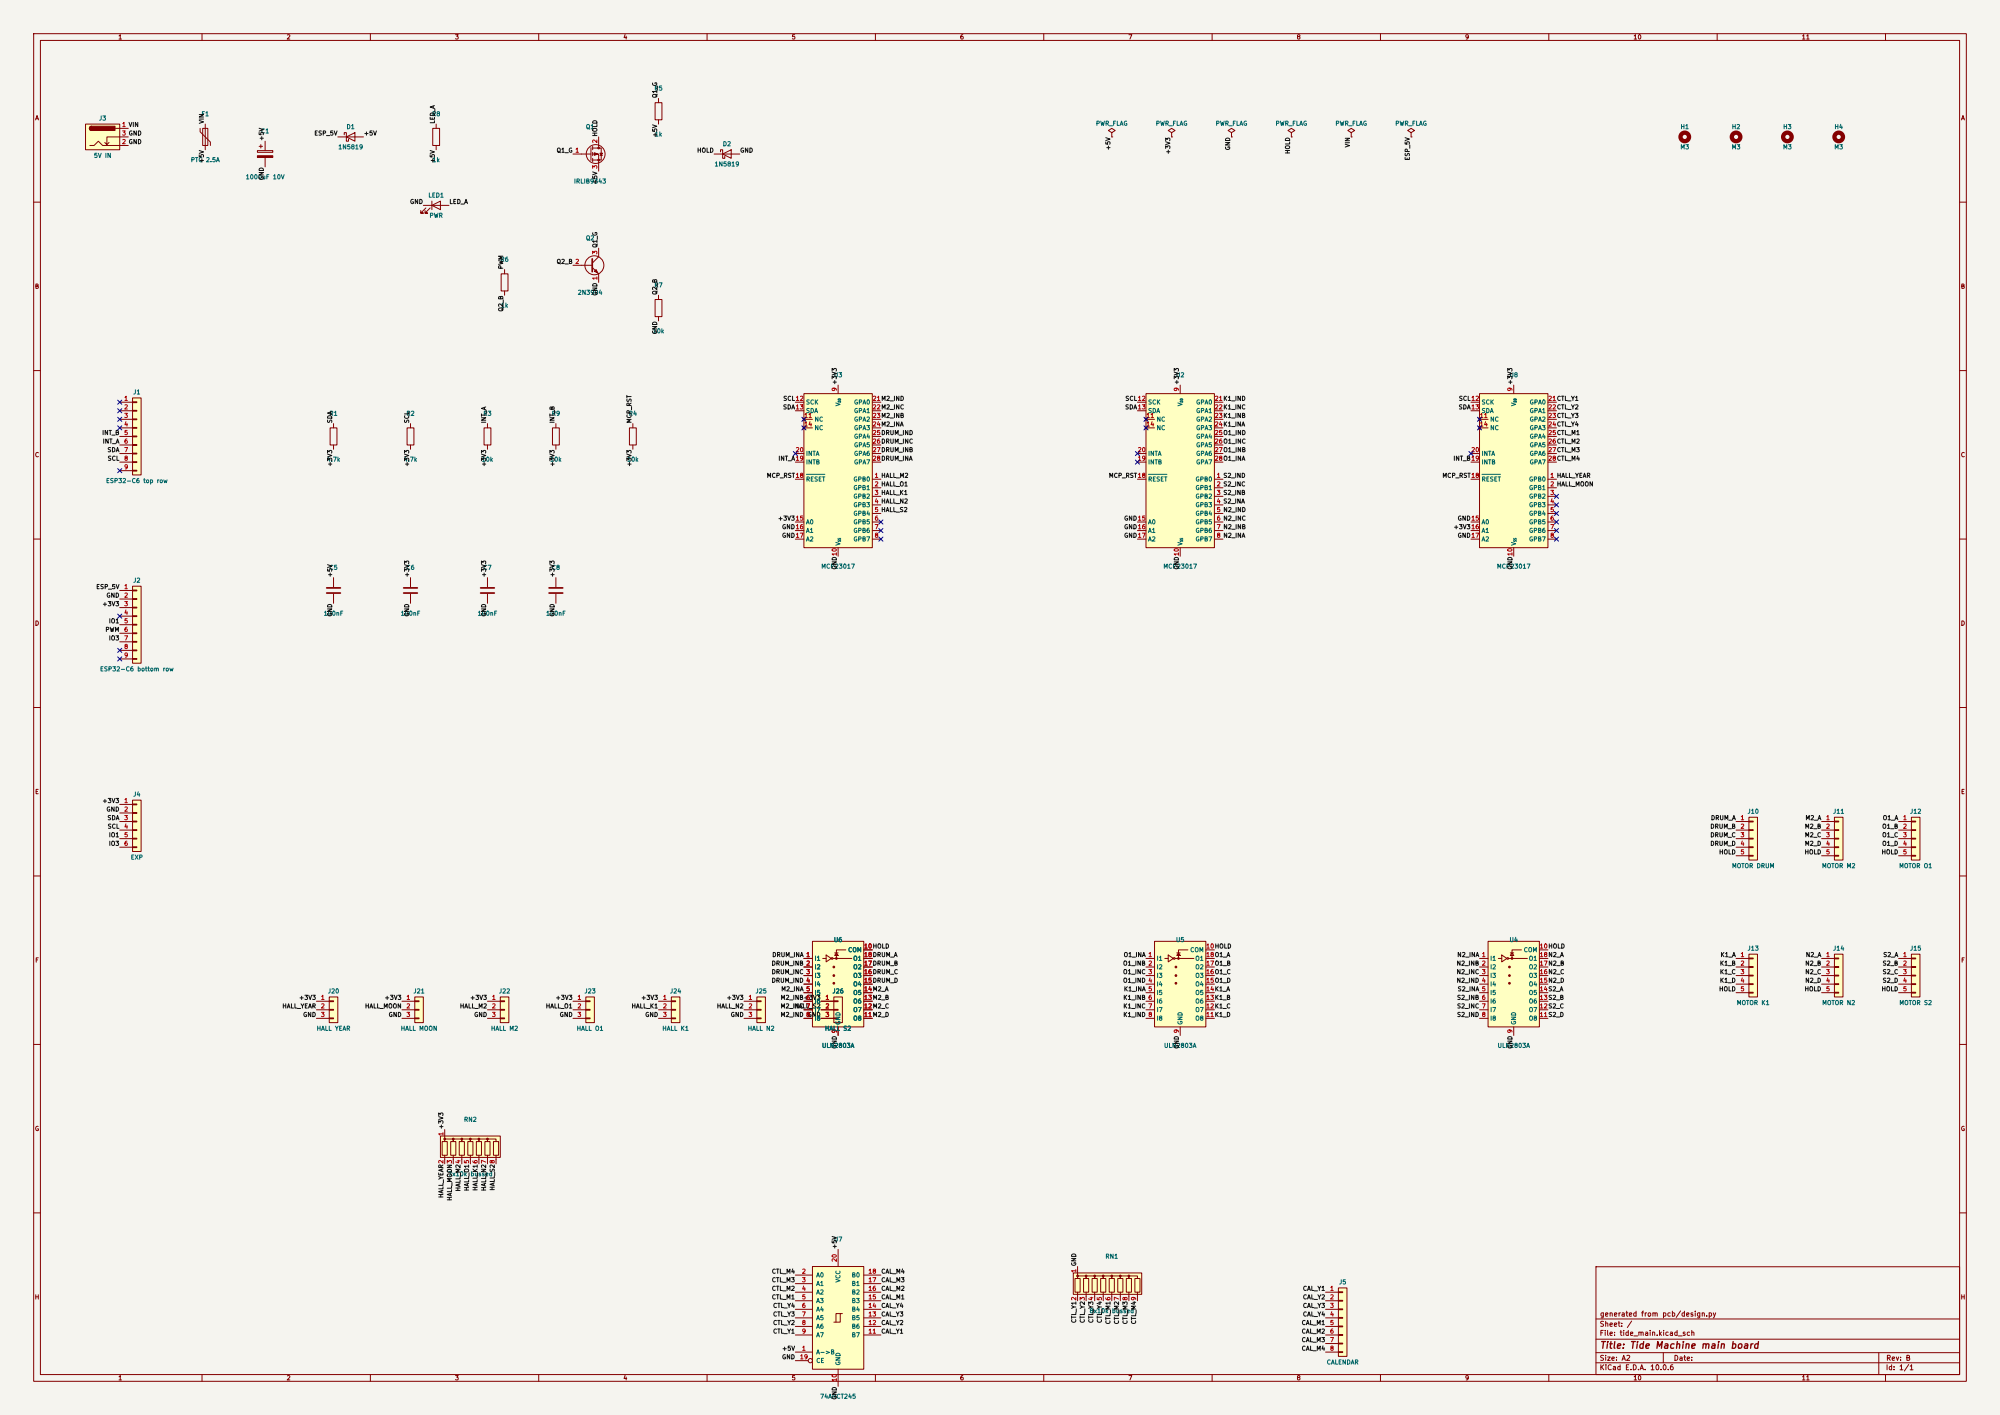
[picture p36: page 1]

generated from pcb/design.py
Sheet: /
File: tide_main.kicad_sch
Title: Tide Machine main board

Size: A2 | Rev: B
KiCad E.D.A. 10.0.6 | Id: 1/1
