MikeMontana1968/tide-machine/pcb/silk_layout_1to1.pdf

U4

## ULN2803A · N2 S2

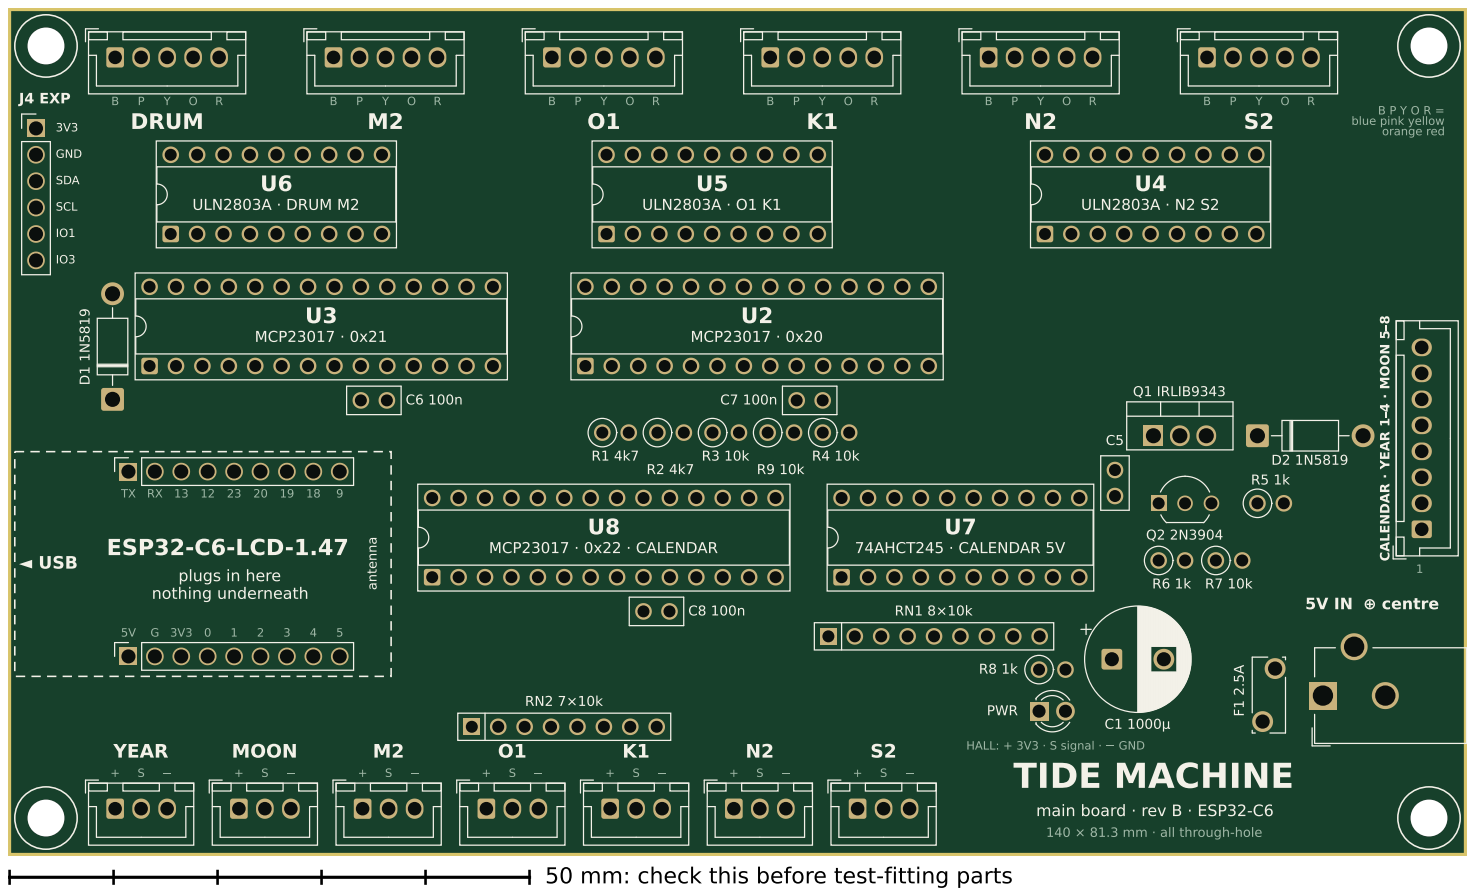
[picture p37: page 1]

main board · rev B · ESP32-C6
140 × 81.3 mm · all through-hole

50 mm: check this before test-fitting parts
