MikeMontana1968/tide-machine/(list of files, drawings)

Other design files:
docs/assembly_guide/tide_wiring.fzz
