MikeMontana1968/tide-machine/pcb/tide_main.kicad_pcb

## KiCad design pcb/tide_main.kicad_pcb (2026-09-27)

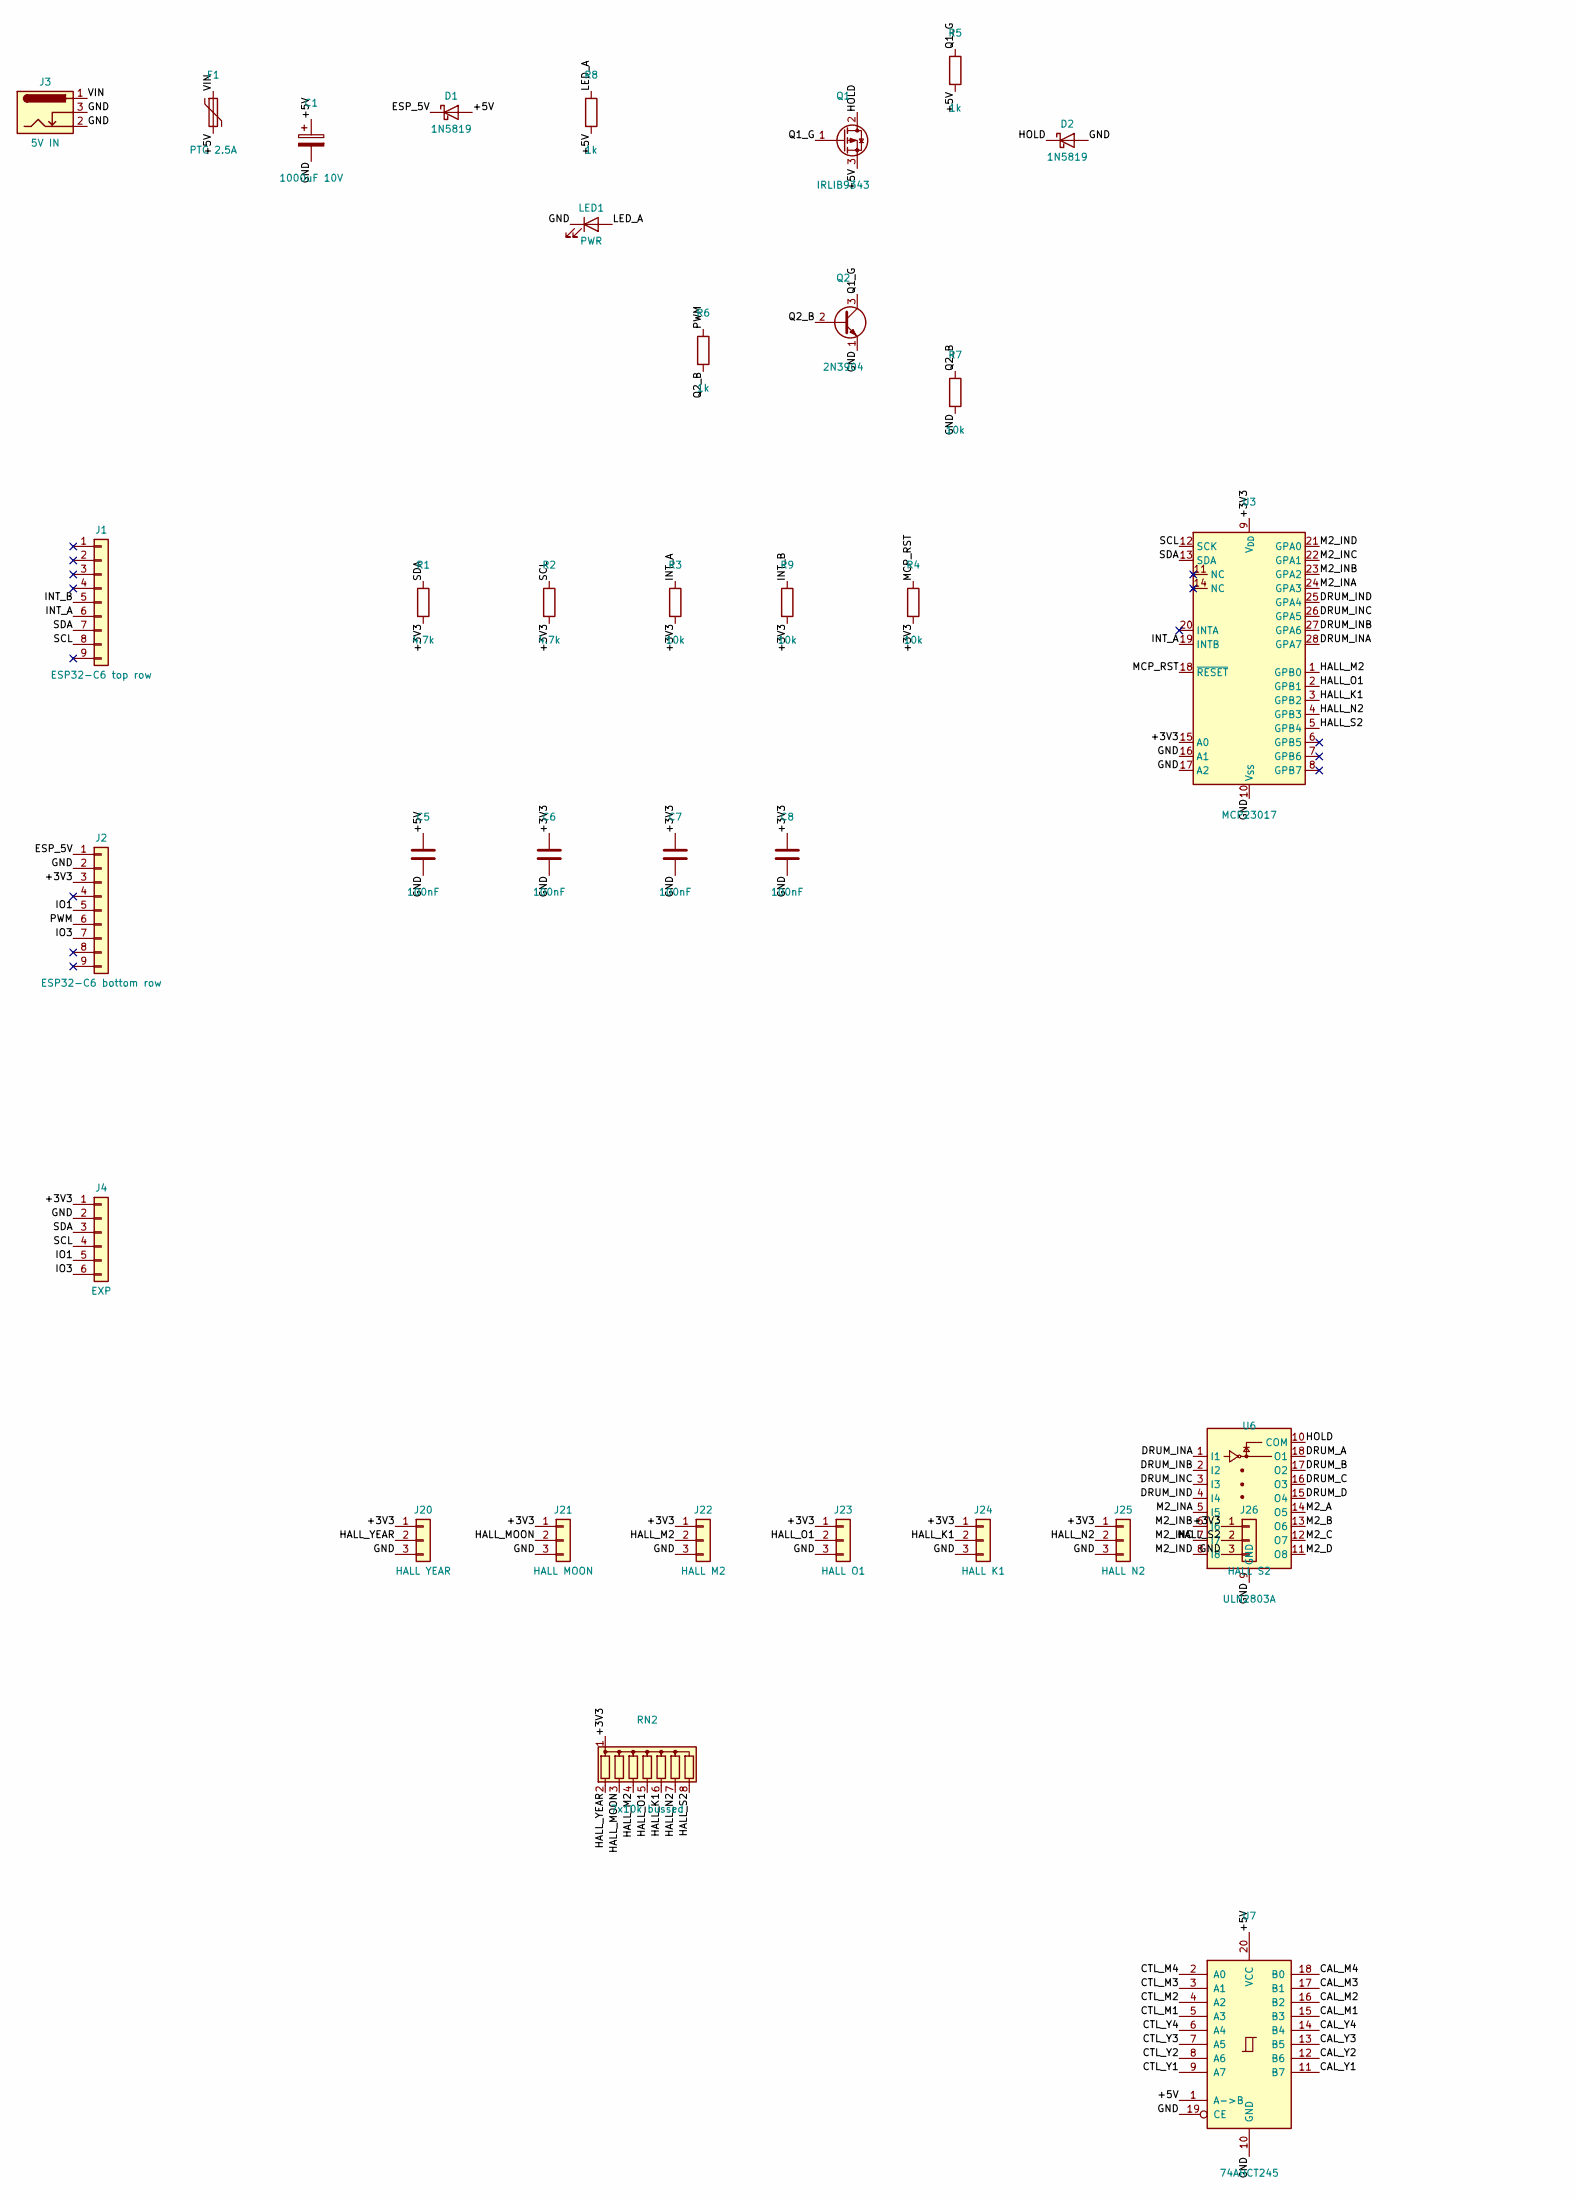
[picture p38: schematic tide_main.kicad_sch, Tide Machine main board, part in row 1, column 1]

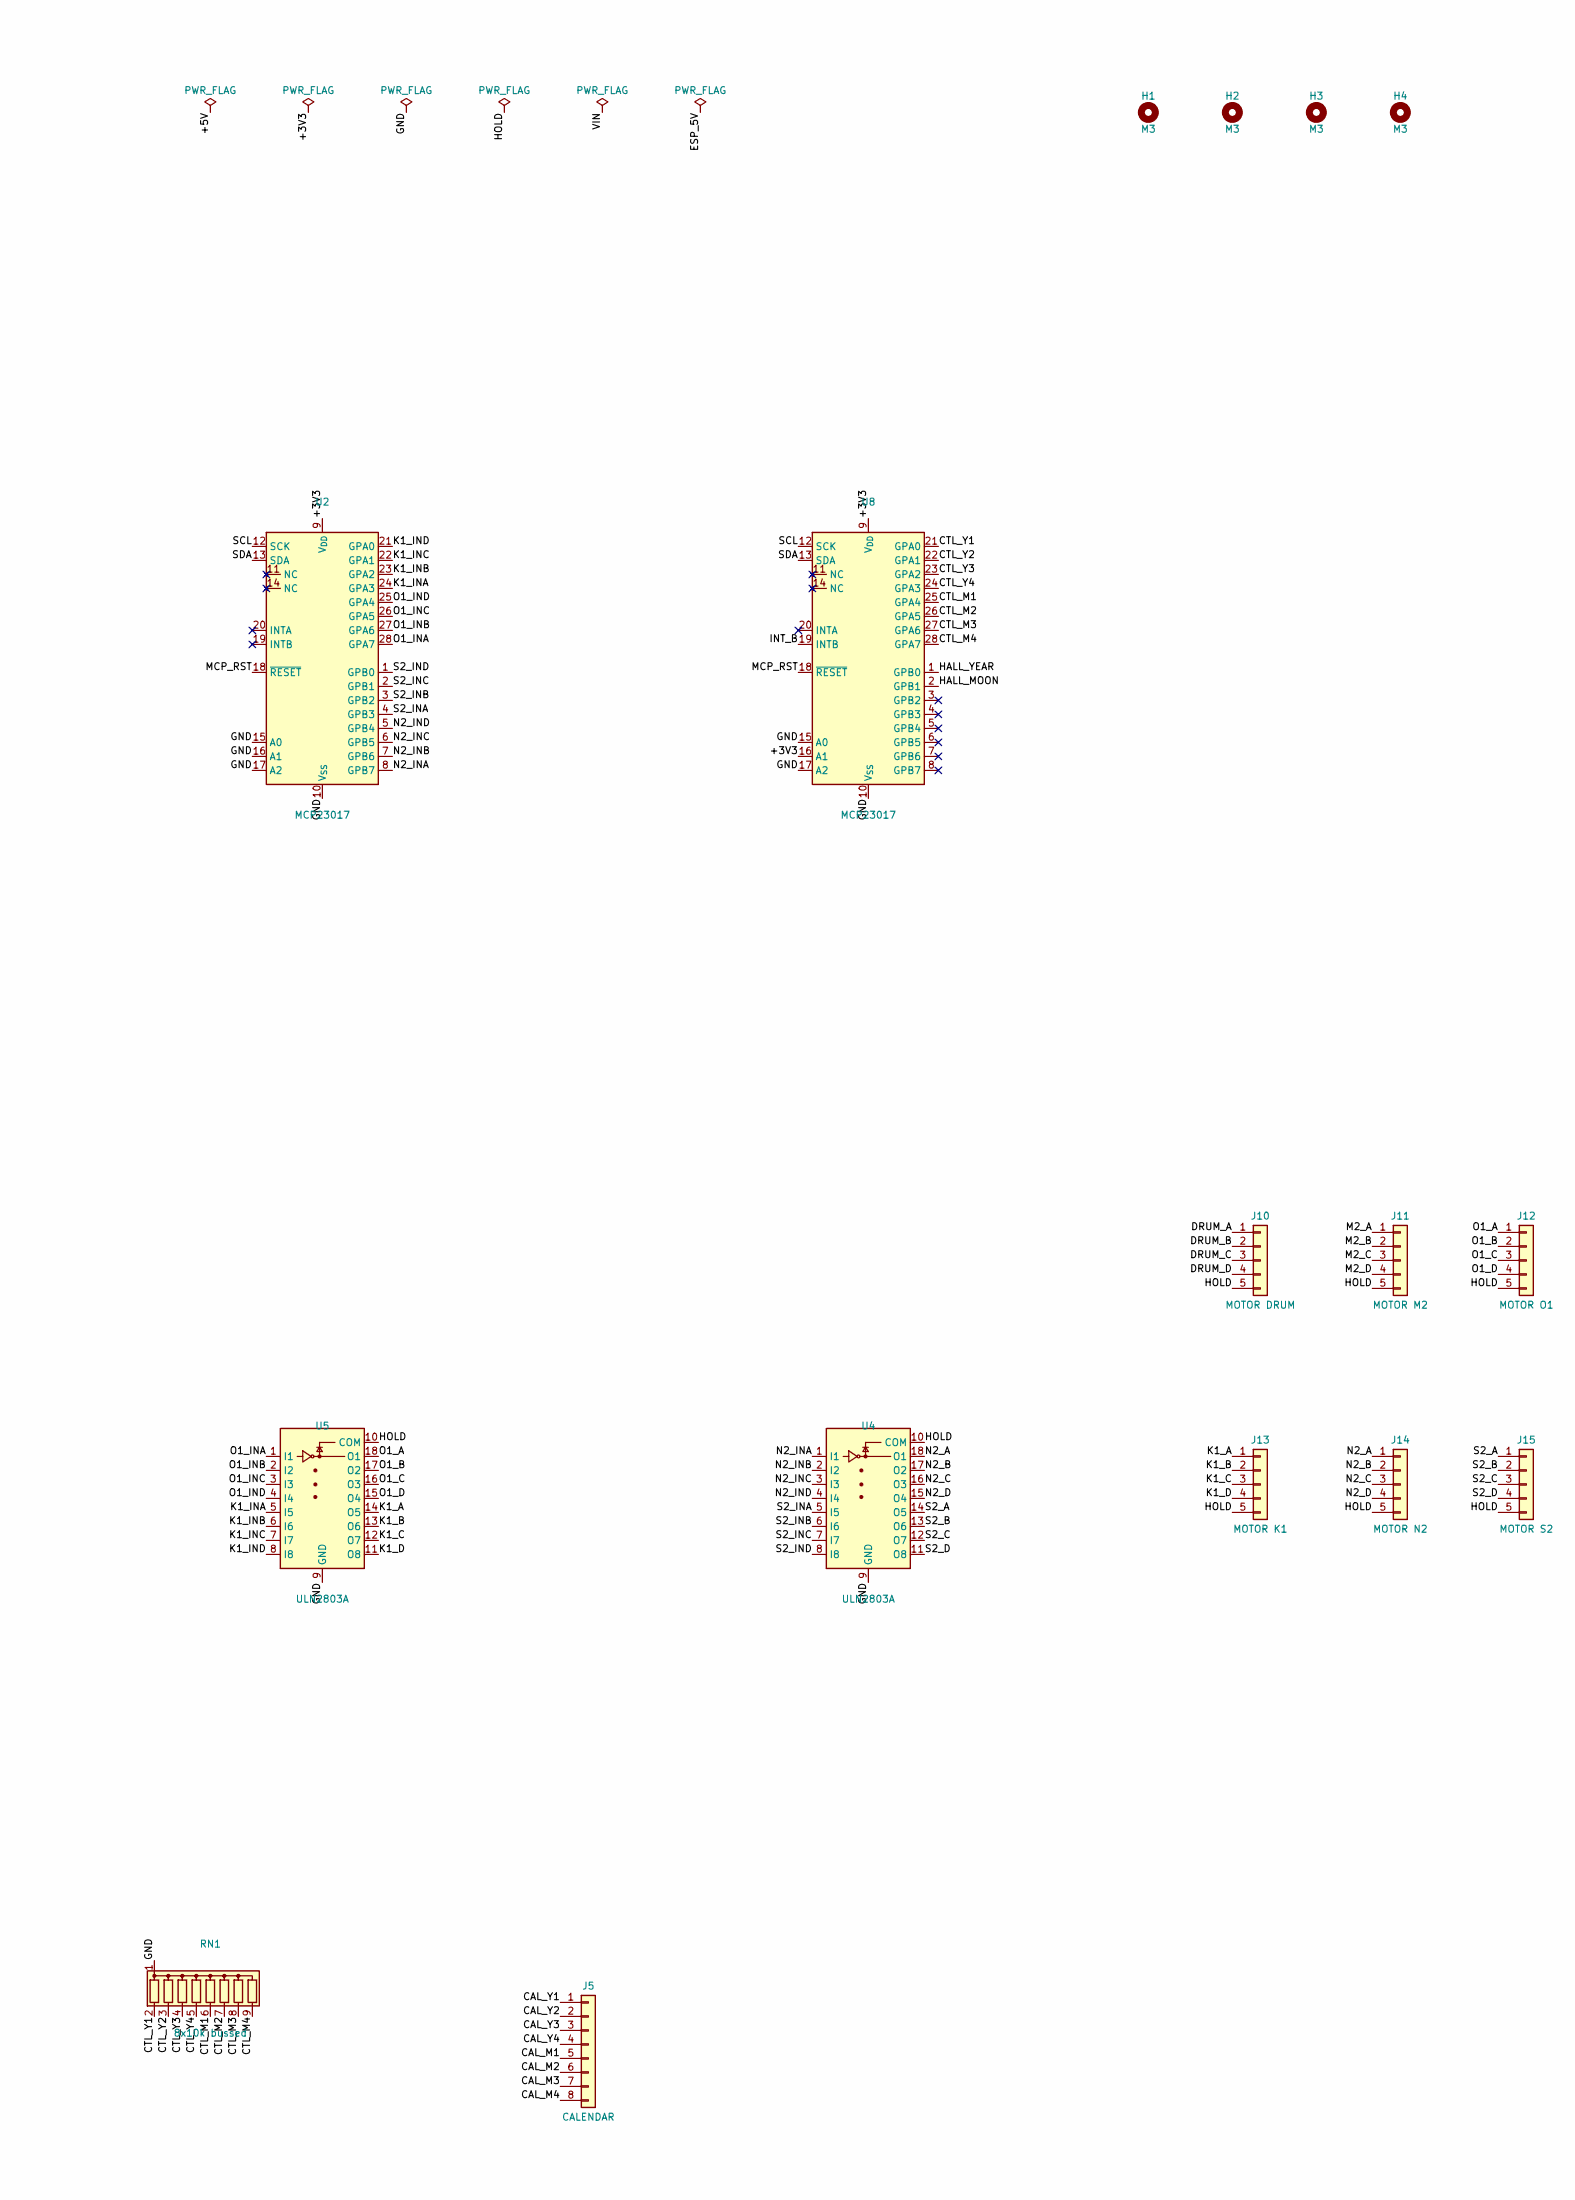
[picture p39: schematic tide_main.kicad_sch, Tide Machine main board, part in row 1, column 2]

Parts:
C1: 1000uF 10V; CP_Radial_D10.0mm_P5.00mm
C5, C6, C7, C8: 100nF; C_Disc_D5.0mm_W2.5mm_P2.50mm
D1, D2: 1N5819; D_DO-41_SOD81_P10.16mm_Horizontal
F1: PTC 2.5A; Fuse_Bourns_MF-RG300
H1, H2, H3, H4: M3; MountingHole_3.2mm_M3
J1: ESP32-C6 top row; PinSocket_1x09_P2.54mm_Vertical
J2: ESP32-C6 bottom row; PinSocket_1x09_P2.54mm_Vertical
J3: 5V IN; BarrelJack_CUI_PJ-102AH_Horizontal
J4: EXP; PinHeader_1x06_P2.54mm_Vertical
J5: CALENDAR; JST_XH_B8B-XH-A_1x08_P2.50mm_Vertical
J10: MOTOR DRUM; JST_XH_B5B-XH-A_1x05_P2.50mm_Vertical
J11: MOTOR M2; JST_XH_B5B-XH-A_1x05_P2.50mm_Vertical
J12: MOTOR O1; JST_XH_B5B-XH-A_1x05_P2.50mm_Vertical
J13: MOTOR K1; JST_XH_B5B-XH-A_1x05_P2.50mm_Vertical
J14: MOTOR N2; JST_XH_B5B-XH-A_1x05_P2.50mm_Vertical
J15: MOTOR S2; JST_XH_B5B-XH-A_1x05_P2.50mm_Vertical
J20: HALL YEAR; JST_XH_B3B-XH-A_1x03_P2.50mm_Vertical
J21: HALL MOON; JST_XH_B3B-XH-A_1x03_P2.50mm_Vertical
J22: HALL M2; JST_XH_B3B-XH-A_1x03_P2.50mm_Vertical
J23: HALL O1; JST_XH_B3B-XH-A_1x03_P2.50mm_Vertical
J24: HALL K1; JST_XH_B3B-XH-A_1x03_P2.50mm_Vertical
J25: HALL N2; JST_XH_B3B-XH-A_1x03_P2.50mm_Vertical
J26: HALL S2; JST_XH_B3B-XH-A_1x03_P2.50mm_Vertical
LED1: PWR; LED_D3.0mm
Q1: IRLIB9343; TO-220-3_Vertical
Q2: 2N3904; TO-92_Inline_Wide
R1, R2: 4.7k; R_Axial_DIN0207_L6.3mm_D2.5mm_P2.54mm_Vertical
R3, R4, R7, R9: 10k; R_Axial_DIN0207_L6.3mm_D2.5mm_P2.54mm_Vertical
R5, R6, R8: 1k; R_Axial_DIN0207_L6.3mm_D2.5mm_P2.54mm_Vertical
RN1: 8x10k bussed; R_Array_SIP9
RN2: 7x10k bussed; R_Array_SIP8
U2, U3, U8: MCP23017; DIP-28_W7.62mm_Socket
U4, U5, U6: ULN2803A; DIP-18_W7.62mm_Socket
U7: 74AHCT245; DIP-20_W7.62mm_Socket

Connections:
+3V3: C6.1, C7.1, C8.1, J2.3, J4.1, J20.1, J21.1, J22.1, J23.1, J24.1, J25.1, J26.1, R1.2, R2.2, R3.2, R4.2, R9.2, RN2.1 (common), U2.9 (V_{DD}), U3.9 (V_{DD}), U3.15 (A0), U8.9 (V_{DD}), U8.16 (A1)
+5V: C1.1, C5.1, D1.2 (A), F1.2, Q1.3 (S), R5.2, R8.2, U7.1 (A->B), U7.20 (VCC)
CAL_M1: J5.5, U7.15 (B3)
CAL_M2: J5.6, U7.16 (B2)
CAL_M3: J5.7, U7.17 (B1)
CAL_M4: J5.8, U7.18 (B0)
CAL_Y1: J5.1, U7.11 (B7)
CAL_Y2: J5.2, U7.12 (B6)
CAL_Y3: J5.3, U7.13 (B5)
CAL_Y4: J5.4, U7.14 (B4)
CTL_M1: RN1.6 (R5), U7.5 (A3), U8.25 (GPA4)
CTL_M2: RN1.7 (R6), U7.4 (A2), U8.26 (GPA5)
CTL_M3: RN1.8 (R7), U7.3 (A1), U8.27 (GPA6)
CTL_M4: RN1.9 (R8), U7.2 (A0), U8.28 (GPA7)
CTL_Y1: RN1.2 (R1), U7.9 (A7), U8.21 (GPA0)
CTL_Y2: RN1.3 (R2), U7.8 (A6), U8.22 (GPA1)
CTL_Y3: RN1.4 (R3), U7.7 (A5), U8.23 (GPA2)
CTL_Y4: RN1.5 (R4), U7.6 (A4), U8.24 (GPA3)
DRUM_A: J10.1, U6.18 (O1)
DRUM_B: J10.2, U6.17 (O2)
DRUM_C: J10.3, U6.16 (O3)
DRUM_D: J10.4, U6.15 (O4)
DRUM_INA: U3.28 (GPA7), U6.1 (I1)
DRUM_INB: U3.27 (GPA6), U6.2 (I2)
DRUM_INC: U3.26 (GPA5), U6.3 (I3)
DRUM_IND: U3.25 (GPA4), U6.4 (I4)
ESP_5V: D1.1 (K), J2.1
GND: C1.2, C5.2, C6.2, C7.2, C8.2, D2.2 (A), J2.2, J3.2, J3.3, J4.2, J20.3, J21.3, J22.3, J23.3, J24.3, J25.3, J26.3, LED1.1 (K), Q2.1 (E), R7.2, RN1.1 (common), U2.10 (V_{SS}), U2.15 (A0), U2.16 (A1), U2.17 (A2), U3.10 (V_{SS}), U3.16 (A1), U3.17 (A2), U4.9 (GND), U5.9 (GND), U6.9 (GND), U7.10 (GND), U7.19 (CE), U8.10 (V_{SS}), U8.15 (A0), U8.17 (A2)
HALL_K1: J24.2, RN2.6 (R5), U3.3 (GPB2)
HALL_M2: J22.2, RN2.4 (R3), U3.1 (GPB0)
HALL_MOON: J21.2, RN2.3 (R2), U8.2 (GPB1)
HALL_N2: J25.2, RN2.7 (R6), U3.4 (GPB3)
HALL_O1: J23.2, RN2.5 (R4), U3.2 (GPB1)
HALL_S2: J26.2, RN2.8 (R7), U3.5 (GPB4)
HALL_YEAR: J20.2, RN2.2 (R1), U8.1 (GPB0)
HOLD: D2.1 (K), J10.5, J11.5, J12.5, J13.5, J14.5, J15.5, Q1.2 (D), U4.10 (COM), U5.10 (COM), U6.10 (COM)
INT_A: J1.6, R3.1, U3.19 (INTB)
INT_B: J1.5, R9.1, U8.19 (INTB)
IO1: J2.5, J4.5
IO3: J2.7, J4.6
K1_A: J13.1, U5.14 (O5)
K1_B: J13.2, U5.13 (O6)
K1_C: J13.3, U5.12 (O7)
K1_D: J13.4, U5.11 (O8)
K1_INA: U2.24 (GPA3), U5.5 (I5)
K1_INB: U2.23 (GPA2), U5.6 (I6)
K1_INC: U2.22 (GPA1), U5.7 (I7)
K1_IND: U2.21 (GPA0), U5.8 (I8)
LED_A: LED1.2 (A), R8.1
M2_A: J11.1, U6.14 (O5)
M2_B: J11.2, U6.13 (O6)
M2_C: J11.3, U6.12 (O7)
M2_D: J11.4, U6.11 (O8)
M2_INA: U3.24 (GPA3), U6.5 (I5)
M2_INB: U3.23 (GPA2), U6.6 (I6)
M2_INC: U3.22 (GPA1), U6.7 (I7)
M2_IND: U3.21 (GPA0), U6.8 (I8)
MCP_RST: R4.1, U2.18 (~RESET), U3.18 (~RESET), U8.18 (~RESET)
N2_A: J14.1, U4.18 (O1)
N2_B: J14.2, U4.17 (O2)
N2_C: J14.3, U4.16 (O3)
N2_D: J14.4, U4.15 (O4)
N2_INA: U2.8 (GPB7), U4.1 (I1)
N2_INB: U2.7 (GPB6), U4.2 (I2)
N2_INC: U2.6 (GPB5), U4.3 (I3)
N2_IND: U2.5 (GPB4), U4.4 (I4)
O1_A: J12.1, U5.18 (O1)
O1_B: J12.2, U5.17 (O2)
O1_C: J12.3, U5.16 (O3)
O1_D: J12.4, U5.15 (O4)
O1_INA: U2.28 (GPA7), U5.1 (I1)
O1_INB: U2.27 (GPA6), U5.2 (I2)
O1_INC: U2.26 (GPA5), U5.3 (I3)
O1_IND: U2.25 (GPA4), U5.4 (I4)
PWM: J2.6, R6.1
Q1_G: Q1.1 (G), Q2.3 (C), R5.1
Q2_B: Q2.2 (B), R6.2, R7.1
S2_A: J15.1, U4.14 (O5)
S2_B: J15.2, U4.13 (O6)
S2_C: J15.3, U4.12 (O7)
S2_D: J15.4, U4.11 (O8)
S2_INA: U2.4 (GPB3), U4.5 (I5)
S2_INB: U2.3 (GPB2), U4.6 (I6)
S2_INC: U2.2 (GPB1), U4.7 (I7)
S2_IND: U2.1 (GPB0), U4.8 (I8)
SCL: J1.8, J4.4, R2.1, U2.12 (SCK), U3.12 (SCK), U8.12 (SCK)
SDA: J1.7, J4.3, R1.1, U2.13 (SDA), U3.13 (SDA), U8.13 (SDA)
VIN: F1.1, J3.1

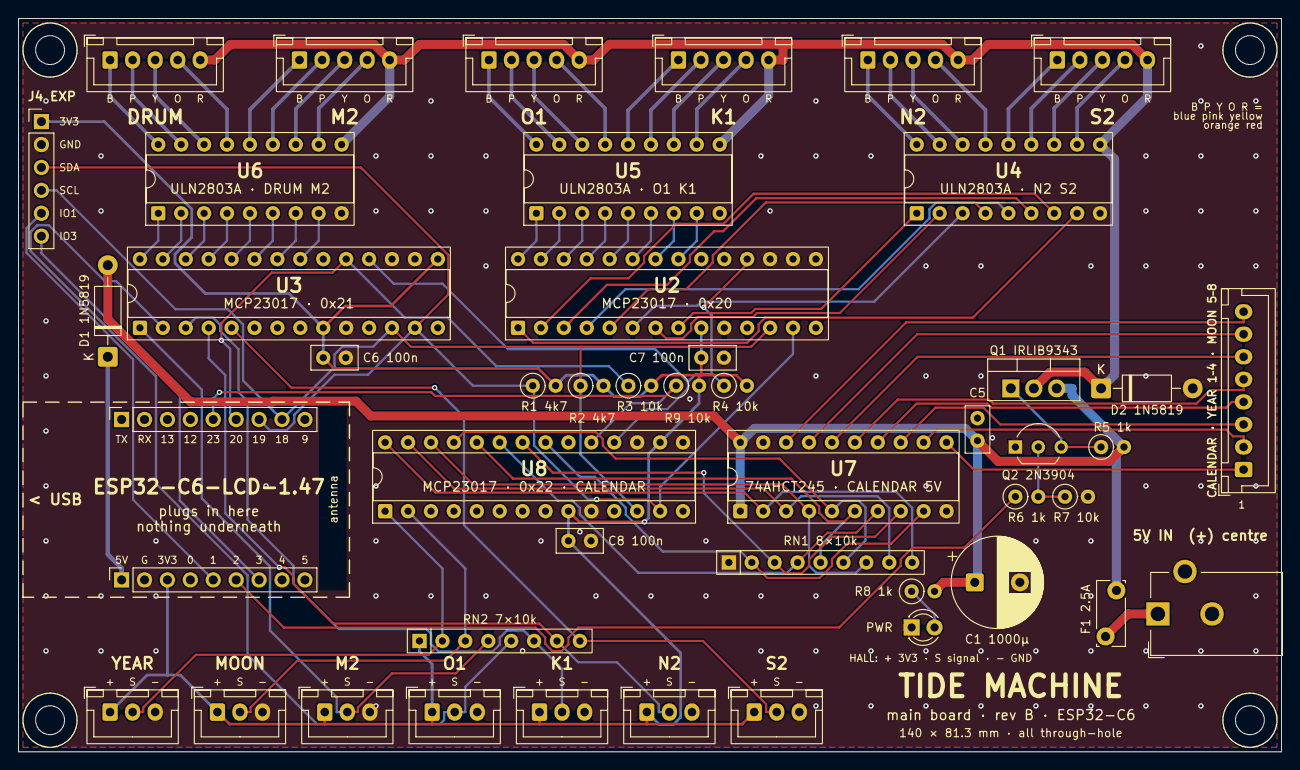
[picture p40: board tide_main.kicad_pcb from above]

Board: 2 copper layers, 140.0 x 81.3 mm, 51 parts (0 on the bottom side), 88 nets.
