MikeMontana1968/tide-machine/(commit log)

2026-09-24 Mechanical tide predictor: model, drawings, viewer
    A desktop harmonic tide machine. Five crank discs pressed onto 28BYJ-48
    output shafts behind a sheet-metal faceplate; one monofilament line sums
    their displacements Kelvin-fashion and drives a pen against a PVC drum.
    Five constituents (M2 S2 N2 K1 O1) hold worst-case error to 12.4% and
    5.1% RMS over 60 days against a 20% target.
    tide_machine.rb parametric SketchUp builder -- the source of truth
    for every dimension in the project
    tide-machine-3d.html Three.js viewer, a parallel implementation
    faceplate.py emits the faceplate DXF + 1:1 PDFs
    rails.py emits the rail drilling temp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
    [faceplate_CUT.dxf, faceplate_REF.dxf, rails_REF.dxf]
2026-09-26 Rev M: arm stations, coaxial V-groove pulleys, TCST2202 home sensors
    Replace Rev L's disc + Scotch yoke + carriage stations with arms driven
    through a per-station firmware inverse. Every bend in the line is now a
    V623ZZ: coaxial pulley pairs above each shaft (threading mirrored at
    alternate stations) and one bearing on each arm. Home sensing moves to a
    Vishay TCST2202 lying flat on the faceplate at 12 o'clock, read by a fin
    on a flag disc behind the arm.
    - station_study.py / .tmpl.html / .html: two-station fit study (O1 + M2),
    15 clearance checks, depth stack
    - rollers.py: pulley bracket geometry and threading table (writes an STL
    only when run directly)
    - sandbox/: Marigram Sandbox sou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
    [rollers.py, station_study.py]
2026-09-26 Rev M: Hall sensing, calendar dial, decals, build pack, printability
    - Hall latches (DRV5013) behind the aluminium plate read 5x2 N52 magnet
    pairs through plate windows; shrunk depth stack, line plane z -15.0
    - V623ZZ on every bend incl. the arms; firmware inverse per station
    (kinematics.py); rails 152 apart for the pen travel window
    - Pen carriage on four V623ZZ riding 3 mm steel rods, in front of the line
    - BKA30D-R5 calendar: year dial + moon disc at (-140, -48)
    - decals.py: warped scales with astronomical zeros, year and moon decals
    - buildpack.py: BOM (bom.csv) + wiring diagram and pin map (build_pack.html)
    - revm_model.html: full-machine viewer from station_study.py --full
    - Printa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
    [bom.csv]
2026-09-27 Main board: through-hole layout, silkscreen, Mouser BOM
    - pcb/design.py: one 127 x 81.3 mm all-through-hole board as data (parts,
    KiCad footprints, placement, netlist, net classes, firmware bit tables).
    Edge connectors: six 28BYJ-48 sockets, seven Hall sockets, calendar,
    barrel jack, expansion header; ESP32-DevKitC socketed with nothing
    underneath and USB at the left edge
    - Calendar motor driven directly by the 74AHCT245 (AX1201728SG dropped,
    SMD-only); IRLIB9343 + 2N3904 hold switch with a 1N5819 freewheel diode;
    DRV5013 in TO-92
    - pcb/layout.py + fplib.py + render.py: placement checks against the real
    KiCad footprints (courtyards, edges, DevKit keep-out)
    - pcb/silk.py: silksc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
    [bom.csv, mouser_bom.csv]
2026-09-27 Main board routed in KiCad 10, DRC clean, Gerbers ready
    - pcb/build_board.py (KiCad's Python): places design.py's footprints from
    KiCad's library, nets and net classes, outline, silkscreen labels, GND
    pours on both layers, keep-outs under the antenna and standoffs
    - pcb/route.py: two-layer grid A* router (turn and via costs, exact
    clearance rasters per net class), GND fix-up, stitching and fragment
    vias. Freerouting was unobtainable (GitHub downloads throttled)
    - pcb/make_board.py: build -> route -> pour/stitch -> DRC loop -> Gerbers,
    drill, zip, 3D renders. KiCad DRC: 0 errors, 0 unconnected
    - 708 track segments, 66 signal vias, ~100 GND stitching vias
    - TO-92 moved to the wide fo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
    [bom.csv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]
2026-09-27 Main board rev B: ESP32-C6-LCD-1.47, third MCP23017, Freerouting
    - MCU is now the Waveshare ESP32-C6-LCD-1.47 in two 1x9 sockets, USB-C at
    the left edge, nothing underneath it. Only 8 free GPIOs, so a third
    MCP23017 (0x22) drives the calendar coils (via the 74AHCT245) and reads
    the year/moon latches; the ESP32 uses GPIO18/19 (I2C), 20/23 (INT), 2 (PWM)
    - Board widened to 140 x 81.3 mm; silkscreen labels follow their parts
    - make_board.py routes with Freerouting 2.4.1 (headless, Java 25):
    DSN export without GND -> Freerouting -> SES import -> pours, stitching,
    DRC loop. 569 segments, 8 signal vias, KiCad DRC 0 errors/0 unconnected
    - +3V3 gets its own 0.3 mm class; GND clearance 0.2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
    [bom.csv, mouser_bom.csv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]
2026-09-28 Assembly guide (flat-pack style), model fixes it found, STLs, KiCad schematic
    docs/assembly_guide: 49-step guide built with the flatpack-guide kit.
    Every drawing comes from the Rev M model through gen_geom.py -> tide_geom.js.
    The wiring is a generated Fritzing sketch (gen_fritzing.py -> tide_wiring.fzz).
    The page is built into tide_machine_guide.html + .pdf and published as an artifact.
    Fixed in station_study.py, verified with check_interference.py and the fit
    study (31 clearances, all >= 0.98 mm):
    - arm-bearing and pen-pulley axle heads now clamp a 3x5x0.5 shim;
    an M3 washer pressed on the V623ZZ shield
    - pen arm moved 1 mm in front of the guide rods; it ran through the +x rod
    - calendar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
    [arm_K1.stl, arm_M2.stl, arm_N2.stl, arm_O1.stl, arm_S2.stl, bom.csv, calendar_hand.stl, drum_end_cap.stl]
2026-09-28 Record the need for 1:1 Rev M rail templates (KI 13)
    RESUME.md open item and assembly-guide KI 13: rails.py templates are Rev L; list
    every Rev M hole position from the S2 end of the rail (bracket pilots, rod sockets,
    drum hole, faceplate and end-post pilots). Steps 11 and 13 link to it; guide rebuilt.
2026-10-18 Assembly guide: beginner board section, probe maps, square wiring; vendor the kit
    Main board section rewritten for a first-time solderer: one part kind at a
    time (resistors, networks, ceramics, C1, diodes/LED, chip sockets, C6 sockets
    and J4, JST-XH, fuse and jack, transistors), each with a how sheet and a
    top-down board map with values and tick boxes; soldering basics, male vs
    female, a quick first-light check. Steps renumbered 1-60.
    Smoke tests: every test shows where the meter leads go on the real board
    (magnified bubbles, probe points in empty socket holes and header pins), the
    meter is titled with its mode, powered tests show the 5 V supply below the
    board with its leads into J3. Test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
